Anirudh-65/FPGA-Based_Hardware_Accelerated_Matrix-Multiplication_on_RISC-V_Using_Systolic-Array_Integration/Project_Documentation_RISCV_matmul.pdf

## FPGA-Based Hardware Acceleration of Matrix Multiplication on RISC-V Using a Custom Systolic Array

Arjun Mallya, Anirudh Mittal, Shah Tirth

July 4, 2025

Abstract

Matrix multiplication is a core computational primitive in signal processing, scientific computing, and machine learning, yet its inherent O(n

3
) complexity makes it a major performance bottleneck on sequential processors. This report presents a hardware-accelerated implementation of matrix multiplication through a custom instruction extension to the RV32IM RISC-V core. A dedicated systolic array accelerator is integrated into the five-stage RISC-V pipeline via a custom matmul instruction, with modifications made to both the GNU RISC-V toolchain and the Spike simulator for software simulation. The Verilog-based hardware architecture incorporates a wrapper for operand control, a counter for profiling, and UART for runtime validation. The complete system was prototyped on a Xilinx Nexys4 DDR FPGA [?], and performance profiling via waveform analysis and post-implementation timing reports demonstrated a substantial reduction in execution cycles, reducing the effective computational complexity significantly. This work underscores the potential of custom ISA extensions and domain-specific accelerators in advancing the performance of open-source RISC-V-based embedded computing platforms.

## Contents

1 Introduction | 4
2 Theoretical Background | 4
3 Module Overview | 7
4 Introduction to RISC-V GNU Toolchain and Spike ISA Simulator | 22

### 5 Integration of Custom Matmul instruction to GNU Toolchain and Spike Simulator 23

6 Modifications to RISC-V GNU Toolchain | 24
7 Modifications to RISC-V Spike Simulator | 24

8 Current Status and Testing | 25

## 1 Introduction

RISC-V is an open-source, modular ISA known for its simplicity and extensibility. The RV32IM variant, featuring a 32-bit integer instruction set and a classic five-stage pipeline, is ideal for custom instruction integration and experimentation with hardware accelerators. To overcome the O(n

3
) cost of matrix multiplication on sequential processors, we extend the RISC-V ISA with a custom matmul instruction. This instruction is supported end-to-end—from software simulation using a modified Spike toolchain to hardware acceleration via a systolic array integrated on FPGA—significantly reducing execution time while preserving pipeline compatibility.

## 2 Theoretical Background

This section outlines the theoretical foundations essential for understanding the design and implementation of a custom matrix multiplication instruction within the RV32IM RISC-V architecture, including the integration of a hardware accelerator and associated peripheral systems.

### 2.1 RISC-V Instruction Set Architecture (ISA)

RISC-V is an open-source, modular ISA designed to support a wide range of computing systems. Its clean, extensible architecture has led to widespread academic and industrial adoption. The base ISA is categorized by its register width and supported instruction types. In this project, we use the RV32IM variant, which supports 32-bit integer operations (RV32I) and integer multiplication and division extensions (M).

### 2.2 General Purpose Registers (GPRs)

RISC-V defines 32 general-purpose registers (x0–x31), each 32 bits wide in the RV32 architecture. Register x0 is hardwired to zero. The standard naming convention for these registers is as follows:

Register | ABI Name | Description
x0 x1 x2 x3 x4 x5–x7 x8 x9 x10–x11 x12–x17 x18–x27 x28–x31 | zero ra sp gp tp t0–t2 s0/fp s1 a0–a1 a2–a7 s2–s11 t3–t6 | Constant zero Return address Stack pointer Global pointer Thread pointer Temporaries Saved register / frame pointer Saved register Function arguments / return values Function arguments Saved registers Temporaries

Table 1: RISC-V General Purpose Registers

### 2.3 Pipeline Architecture and Instruction Decoding

The RV32IM core used in our design is a classic 5-stage pipeline architecture comprising the following stages:

- Instruction Fetch (IF): Retrieves instructions from memory.
- Instruction Decode (ID): Decodes the fetched instruction and reads operands from the register file.

- Execute (EX): Performs ALU operations or address computation.
- Memory Access (MEM): Accesses data memory for load/store instructions.
- Write Back (WB): Writes results back to the register file.

In the decode stage, the instruction is identified based on the opcode, funct3, and funct7 fields. Custom instructions use opcodes from the reserved CUSTOM-0 to CUSTOM-3 space.

### 2.4 RISC-V Instruction Formats

RISC-V defines several instruction formats to accommodate different types of operations within its reduced instruction set architecture. Each format specifies how the 32-bit instruction word is partitioned into opcode, register identifiers, immediate values, and function fields. The primary formats used in the RV32I base ISA are:

- R-type: Used for register-register operations (e.g., add, sub, mul)
- I-type: Used for immediate operations and loads (e.g., addi, lw)
- S-type: Used for store instructions (e.g., sw)
- B-type: Used for conditional branches (e.g., beq, bne)
- U-type: Used for upper immediate operations (e.g., lui, auipc)
- J-type: Used for jump instructions (e.g., jal)
Format | Fields (bit positions) | Use Case
R-type I-type S-type B-type U-type J-type | [31:25] funct7, [24:20] rs2, [19:15] rs1, [14:12] funct3, [11:7] rd, [6:0] opcode [31:20] imm, [19:15] rs1, [14:12] funct3, [11:7] rd, [6:0] opcode [31:25] imm[11:5], [24:20] rs2, [19:15] rs1, [14:12] funct3, [11:7] imm[4:0], [6:0] opcode [31], [30:25], [11:8], [7] (combined as imm), [24:20] rs2, [19:15] rs1, [14:12] funct3, [6:0] opcode [31:12] imm, [11:7] rd, [6:0] opcode [31], [30:21], [20], [19:12] (combined as imm), [11:7] rd, [6:0] opcode | Register-register ALU ops Loads, immediate ALU ops Stores Conditional branches Load upper immediate, AUIPC Jumps

Table 2: RISC-V Instruction Formats

### 2.5 Our Custom matmul Instruction Format

The custom matmul instruction follows the R-type format, aligning with standard ALU operations. It uses the CUSTOM-0 opcode space, which is reserved for user-defined extensions. This design ensures compatibility with the RISC-V decoder logic and avoids conflicts with standard instructions.

1 | ‘define OPCODE_CUSTOM_0 | 7 ’ b0001011
2 | ‘define FUNCT3_MATMUL | 3 ’ b000
3 | ‘define FUNCT7_MATMUL | 7 ’ b0000000

4
5 | ‘define INST_MATMUL | { ‘FUNCT7_MATMUL , 5 ’ h0 , 5 ’ h0 , ‘FUNCT3_MATMUL , 5 ’ h0 ,
| ‘OPCODE_CUSTOM_0 }
6 | ‘define INST_MATMUL_MASK | {7 ’ h7F , 5 ’ h0 , 5 ’ h0 , 7 ’ h7 , 5 ’ h0 , 7 ’ h7F }

Listing 1: Custom Matrix Multiplication Instruction Definition

In this instruction:

- rd stores the base address of matrix C (the result),
- rs1 and rs2 store the base addresses of matrices A and B, respectively.

When this instruction is detected in the Decode (ID) stage of the processor, the pipeline is stalled and control is handed over to the custom Matmul Wrapper module. This wrapper loads the operands from memory, interfaces with the Systolic Array for computation, and writes the resulting matrix back to the memory starting at the address specified by rd.
This setup allows for tight coupling between the custom hardware accelerator and the RISC-V core, ensuring low-latency interaction and efficient data movement through the memory system. It exemplifies the flexibility of RISC-V in supporting domain-specific architectural extensions.

### 2.6 Systolic Array and Hardware Acceleration

The systolic array is a 2D mesh of processing elements that enables high-throughput matrix multiplication. It operates on streamed data with inherent parallelism and is particularly efficient for dense matrix operations.
In our implementation, a Matmul Wrapper module handles the interface between the RISC-V core and the systolic array. It fetches the operand matrices from memory, streams them into the array, and writes the result matrix back to memory.

### 2.7 Performance Counters

To evaluate performance, a 64-bit hardware performance counter was integrated. This counter starts on execution and stops upon completion of the matmul operation. It can be accessed through custom Control and Status Registers (CSRs). The counter tracks the total number of clock cycles taken by a program, enabling accurate performance profiling and comparison between hardware-accelerated and software-only executions.

### 2.8 UART (Universal Asynchronous Receiver Transmitter)

UART is a hardware communication protocol that facilitates serial data transfer between the FPGA and a host PC. It converts parallel data from the processor into serial form and vice versa. UART was used in this project for debugging and verification purposes by transmitting matrix values and performance results from the FPGA to a PC terminal.
The UART setup includes:
- Baud Rate Configuration
- Data Register Interface
- Start/Stop Bit Synchronization

The UART was instantiated and mapped to specific memory addresses in the address space, enabling the processor to write data directly to it for transmission.

### 2.9 FPGA and Vivado Integration

The hardware design was implemented on a Xilinx Nexys4 DDR FPGA, an educational development board powered by the Artix-7 FPGA. The board includes:

- 15,850 logic slices
- 4,860 Kbits of block RAM
- 90 DSP slices

- On-board USB-JTAG and UART

We used Vivado Design Suite for synthesis, placement, routing, and timing analysis. During post-implementation, we observed timing violations due to default 100 MHz clocking. These were mitigated using Vivado’s Clock Wizard IP to generate a 65 MHz derived clock that met all timing constraints, ensuring reliable execution.

Together, these components formed the theoretical and practical foundation for realizing the project goal of efficient hardware-accelerated matrix multiplication using custom RISC-V extensions.

## 3 Module Overview

### 3.1 Riscv Fetch

Purpose:

- Requests instructions from the instruction cache using the current Program Counter (PC).
- Handles stalls, cache responses, and flushes due to mispredicted branches or exceptions.
- Updates the PC, including branch redirection and privilege management.
- Buffers fetch responses using a skid buffer.
- Reports fetch errors such as access faults or page faults.

Inputs:

clk i | Clock input signal. Synchronizes fetch logic.
rst i | Active-high reset. Clears internal state.
fetch accept i | Downstream stage ready to accept fetched instruction.
icache accept i | Instruction cache ready to accept new fetch request.
icache valid i | Valid instruction from instruction cache.
icache error i | Error occurred during instruction fetch (e.g., access fault).
icache inst i[31:0] | Instruction data from cache.
icache page fault i | Page fault indication during fetch.
fetch invalidate i | Invalidate current fetch (e.g., pipeline flush).
branch request i | Indicates a branch redirect.
branch pc i[31:0] | Target PC for branch.
branch priv i[1:0] | Privilege level of branch target.

Outputs:

fetch valid o | Instruction valid for decode.
fetch instr o[31:0] | Instruction to be decoded.
fetch pc o[31:0] | Program Counter of fetched instruction.
fetch fault fetch o | Fetch error (e.g., access fault).
fetch fault page o | Fetch page fault.
icache rd o | Request to read instruction cache.
icache flush o | Flush invalid instruction from cache.
icache invalidate o | Invalidate instruction cache line.
icache pc o[31:0] | PC address for cache read.
icache priv o[1:0] | Privilege level for PC.
squash decode o | Signal to squash instruction in decode stage.

### 3.2 Riscv Decode

Purpose:

- Translates raw 32-bit instruction data into processor control commands.
- Generates control signals for ALU, memory access, and branch units in later pipeline stages.
- Manages pipeline flow by stalling or squashing instructions based on control signals.
- Critical for identifying instructions related to matrix multiplication such as load, multiply, add, and branch.

Inputs:

clk i | System clock (from riscv core).
rst i | System reset (from riscv core).
fetch in valid i | Indicates a new instruction is ready (from fetch).
fetch in instr i | The 32-bit instruction data (from fetch).
fetch in pc i | Instruction memory address (from fetch).
fetch in fault fetch i | Instruction fetch error flag (from fetch).
fetch in fault page i | Instruction fetch page fault flag (from fetch).
fetch out accept i | Signals the Issue stage is ready.
squash decode i | Command to cancel the current instruction (from fetch).

Outputs:

fetch in accept o | Signals this Decode stage is ready (to fetch).
fetch out valid o | Indicates decoded output is valid (to issue).
fetch out instr o | The decoded instruction (to issue).
fetch out pc o | The instruction’s PC (to issue).
fetch out fault fetch o | Fault flags, passed through (to issue).
fetch out fault page o | Page fault flag, passed through (to issue).
fetch out instr exec o | Control signal for ALU operations (to issue).
fetch out instr lsu o | Control signal for Load/Store operations (to issue).
fetch out instr branch o | Control signal for Branch/Jump operations (to issue).
fetch out instr mul o | Control signal for Multiply unit (to issue).
fetch out instr div o | Control signal for Divide unit (to issue).
fetch out instr csr o | Control signal for CSR access (to issue).
fetch out instr rd valid o | Signals a register write-back is needed (to issue).
fetch out instr invalid o | Flags an illegal instruction (to issue).

### 3.3 Riscv Decoder

Purpose:

- Implements the RISC-V ISA decoding as a purely combinational logic block.
- Matches the input opcode against predefined bitmasks for all supported instructions.
- Categorizes instructions by asserting control flags (e.g., exec o, lsu o).
- Acts as the core control unit, directing instructions to the appropriate execution hardware.

Inputs:

valid i | Indicates the input instruction is valid (from riscv decode).

fetch fault i | Indicates a fetch error occurred (from riscv decode).
enable muldiv i | Enables the M-extension (multiply/divide instructions) (from riscv decode).
opcode i | The 32-bit raw instruction word (from riscv decode).

Outputs:

invalid o | Asserted for unrecognized or illegal opcodes (to riscv decode logic).
exec o | Asserted for ALU instructions (to riscv decode logic).
lsu o | Asserted for Load/Store instructions (to riscv decode logic).
branch o | Asserted for Branch and Jump instructions (to riscv decode logic).
mul o | Asserted for Multiply instructions (to riscv decode logic).
div o | Asserted for Divide/Remainder instructions (to riscv decode logic).
csr o | Asserted for system and CSR instructions (to riscv decode logic).
rd valid o | Asserted if the instruction writes a result to a register (to riscv decode logic).

### 3.4 Riscv Exec

Purpose:

- Executes core operations based on decoded instruction information.
- Generates immediates of various types (I, B, J, U) with proper sign-extension.
- Performs ALU operations such as arithmetic, logic, and shifts.
- Calculates branch/jump target addresses.
- Determines branch prediction outcomes (taken/not taken).
- Forwards ALU results for register file writeback.
- Controls pipeline by signaling branch requests to Fetch/Decode stages.

Inputs:

clk i | Clock input for sequential logic.
rst i | Asynchronous active-high reset.
opcode valid i | Indicates if current instruction in execute stage is valid.
opcode opcode i[31:0] | Full 32-bit instruction opcode.
opcode pc i[31:0] | Program Counter value for current instruction.
opcode invalid i | Flag indicating if instruction is invalid (from Decode stage).
opcode rd idx i[4:0] | Destination register index (rd).
opcode ra idx i[4:0] | Source register A index (rs1).
opcode rb idx i[4:0] | Source register B index (rs2).
opcode ra operand i[31:0] | Value of first source operand (register file read).
opcode rb operand i[31:0] | Value of second source operand (register file read).
hold i | Pipeline stall signal (from memory hazards or data hazards).

Outputs:

branch request o | Signals Fetch/Decode stages about executing a branch in-struction requiring PC update.
branch is taken o | Indicates conditional branch is predicted taken.
branch is not taken o | Indicates conditional branch predicted not taken.
branch source o[31:0] | PC of the branch-causing instruction.
branch is call o | Indicates a function call branch (e.g., JAL, JALR with rd = x1).
branch is ret o | Indicates a function return branch (e.g., JALR to x1 with zero immediate).
branch is jmp o | Indicates an unconditional jump branch.
branch pc o[31:0] | Calculated target PC for the branch.
branch d request o | Delayed branch request signal (typically 1 cycle delay).
branch d pc o[31:0] | Delayed branch target PC.
branch d priv o[1:0] | Dummy privilege output (always 2’b00, no privilege han-dling here).
writeback value o[31:0] | ALU operation result to be written back to register file.

### 3.5 Arithmetic Logic Unit (ALU)

Purpose:

- Core component of the Execute (EX) stage in the RISC-V processor.
- Performs arithmetic and logical operations such as addition, subtraction, bitwise AND, OR, XOR, shifts, and comparisons.
- Uses control signals to select the operation to perform on two operand inputs.
- Produces a result used for calculations, branch decisions, and memory address computations.

Inputs:

alu op[3:0] | ALU operation selector (opcode), controls the operation per-formed. Defined in riscv defs.v.
alu a i[31:0] | Operand A, sourced from the register file.
alu b i[31:0] | Operand B, sourced from the register file.

Outputs:

alu p o[31:0] | ALU result after performing the selected operation on operands A and B.

Opcode Macros:

- ALU ADD
- ALU SUB
- ALU AND
- ALU OR
- ALU XOR

- ALU LESS THAN
- ALU LESS SIGNED
- ALU SHIFTL
- ALU SHIFTR
- ALU SHIFT ARITH

### 3.6 Riscv Issue

Purpose:

- Acts as the control center between Decode and Execute stages.
- Routes decoded signals to appropriate modules while managing pipeline hazards.
- Decodes instructions into opcode, rs1, rs2, rd and reads required registers from the register file.
- Identifies hazards and forwards results to execution units to prevent stalls.
- Stalls the pipeline if forwarding is not possible (e.g., slow operations like division).
- Receives writeback values from execution modules and writes them to the appropriate registers.

Inputs:

clk i | System clock.
rst i | System reset.
fetch valid i | Indicates if a valid instruction is ready.
fetch instr i | The 32-bit raw instruction word.
fetch pc i | PC of the fetched instruction.
fetch fault fetch i | Instruction fetch error from memory.
fetch fault page i | Instruction page fault from MMU.
fetch instr exec i | Decoded: standard ALU operation?
fetch instr lsu i | Decoded: Load/Store operation?
fetch instr branch i | Decoded: Branch/Jump operation?
fetch instr csr i | Decoded: CSR operation?
fetch instr rd valid i | Decoded: Writes to register?
fetch instr invalid i | Decoded: Invalid instruction?
branch exec request i | Branch request signal from Execute.
branch exec is taken i | Indicates conditional branch predicted taken (from Exe-cute).
branch exec is not taken i | Indicates conditional branch predicted not taken (from Ex-ecute).
branch exec source i | PC of the branch-causing instruction (from Execute).
branch exec is call i | Indicates a function call branch (from Execute).
branch exec is ret i | Indicates a function return branch (from Execute).
branch exec is jmp i | Indicates an unconditional jump branch (from Execute).
branch exec pc i | Target PC for the branch (from Execute).
branch d exec request i | Delayed branch request (from Execute).
branch d exec pc i | Delayed target PC (from Execute).
branch d exec priv i | Delayed privilege info (from Execute).
writeback exec value i | Result from standard ALU operations (from Execute).
exec stall request i | Stall request from Execute (e.g., Matmul busy).

exec rd idx i | Destination register index in Execute stage.
writeback mem valid i | Indicates if memory access result is valid.
writeback mem value i | Data read from memory for forwarding.
writeback mem exception i | Memory access exception.
lsu stall i | Stall request from LSU (e.g., cache miss).
csr result e1 value i | Value read from CSR.
csr result e1 write i | CSR write enable.
csr result e1 wdata i | Data to write to CSR.
csr result e1 exception i | CSR-related exceptions (e.g., ecall).
branch csr request i | Branch request from CSR.
branch csr pc i | Target PC from CSR branch.
branch csr priv i | Privilege level from CSR branch.
take interrupt i | Global interrupt pending.
d stall | External debug stall signal from DataHazard.

Outputs:

fetch accept o | Signals that riscv fetch is ready for the next instruction.
branch request o | Global branch signal to update the PC.
branch pc o | Target PC for the branch.
branch priv o | Privilege level for the branch target.
exec opcode valid o | Valid instruction signal for riscv exec.
opcode opcode o | Instruction word passed to riscv exec.
opcode pc o | Instruction PC passed to riscv exec.
opcode invalid o | Invalid instruction flag for riscv exec.
opcode rd idx o | Destination register index passed to riscv exec.
opcode ra idx o | Source register A index passed to riscv exec.
opcode rb idx o | Source register B index passed to riscv exec.
opcode ra operand o | Prepared operand A value for riscv exec.
opcode rb operand o | Prepared operand B value for riscv exec.
lsu opcode valid o | Valid signal for riscv lsu.
lsu opcode opcode o | Instruction word to riscv lsu.
lsu opcode pc o | Instruction PC to riscv lsu.
lsu opcode invalid o | Invalid instruction flag for riscv lsu.
lsu opcode rd idx o | Destination register index to riscv lsu.
lsu opcode ra idx o | Source register A index to riscv lsu.
lsu opcode rb idx o | Source register B index to riscv lsu.
lsu opcode ra operand o | Operand A to riscv lsu.
lsu opcode rb operand o | Operand B to riscv lsu.
csr opcode valid o | Valid signal to CSR unit.
csr opcode opcode o | Instruction word to CSR unit.
csr opcode pc o | Instruction PC to CSR unit.
csr opcode invalid o | Invalid instruction flag to CSR unit.
csr opcode rd idx o | Destination register index to CSR unit.
csr opcode ra idx o | Source register A index to CSR unit.
csr opcode rb idx o | Source register B index to CSR unit.
csr opcode ra operand o | Operand A to CSR unit.
csr opcode rb operand o | Operand B to CSR unit.
csr writeback write o | CSR write enable signal.
csr writeback waddr o | CSR write address.
csr writeback wdata o | CSR write data.

csr writeback exception o | CSR exception flag.
csr writeback exception pc | oPC causing CSR exception.
csr writeback exception addrException address for CSR. o
exec hold o | Stall signal for riscv exec pipeline register.
mul hold o | Stall signal for riscv multiplier pipeline register.
interrupt inhibit o | Signal to temporarily block interrupts.

### 3.7 DataHazard Unit

Purpose:

- Implements a forwarding (or bypassing) mechanism to resolve read-after-write (RAW) data hazards without stalling.
- Checks if the operands needed by the instruction in the Decode stage are being produced by instructions currently in the Execute or Memory stages.
- If a dependency exists, it bypasses the register file and directly forwards the newer result from the Execute or Memory stage to the ALU’s input.
- This forwarding avoids pipeline stalls on dependent instructions, which are common in tight loops and algorithms like matrix multiplication.

Inputs:

reset i | System reset.
id ra index w | Source register 1 index (rs1) in Decode stage.
id rb index w | Source register 2 index (rs2) in Decode stage.
ex rd index r | Destination register index (rd) in Execute stage.
mem rd index w | Destination register index (rd) in Memory stage.
id ra value r | Operand value 1 read from register file in Decode stage.
id rb value r | Operand value 2 read from register file in Decode stage.
ex alu res r | ALU result produced in Execute stage.
mem wb alu result r | ALU result from instruction in Memory stage.
mem rdata w | Data fetched from memory in Memory stage.
mem access w | Indicates memory load occurred in Memory stage.

Outputs:

exe ra r | Corrected operand A value forwarded to Execute stage ALU.
exe rb r | Corrected operand B value forwarded to Execute stage ALU.

### 3.8 Hazard

Purpose:

- Detects the load-use data hazard, where an instruction needs data that a preceding load instruction has not yet fetched from memory.
- Compares the current instruction’s source registers (rs1 or rs2) with the destination register (rd) of the immediately preceding instruction.
- Specifically targets cases where the preceding instruction is a load word (lw).
- If such a hazard is found, asserts the stall signal to pause the pipeline for one cycle, allowing memory access to complete.

- Ensures correctness in common dependency patterns, such as multiply-add sequences in matrix multiplication.

Inputs:

opcode i | The instruction just fetched from memory (from mem i inst i port).
clk i | System clock.
reset i | System reset.

Outputs:

stall | Single-bit signal to pause the pipeline if a load-use hazard is detected.

### 3.9 riscv core

Purpose:

- Acts as the top-level ”schematic” of the processor, instantiating and connecting all major functional blocks (fetch, decode, exec, lsu, multiplier, etc.).
- Defines the complete pipeline structure and orchestrates instruction and data flow across all pipeline stages.
- Connects all control and data paths, including forwarding logic and the stall signal from the DataHazard unit to the issue stage.
- Serves as the boundary between the CPU core and the external system.
- Manages external communication with instruction/data memory and interrupt controllers.

Inputs:

clk i | System clock (from Testbench/System).
rst i | System reset (from Testbench/System).
mem d data rd i | Data received from a load operation (from External Data Memory).
mem d accept i | Data memory handshake signal: memory accepts new re-quest.
mem d ack i | Data memory handshake signal: read/write complete.
mem d error i | Data memory error signal.
mem i inst i | Instruction data fetched from memory (from External In-struction Memory).
mem i accept i | Instruction memory handshake signal: memory accepts new request.
mem i valid i | Instruction memory handshake signal: instruction valid.
mem i error i | Instruction memory error signal.
intr i | External interrupt request (from Testbench/System).
reset vector i | Address where execution starts after reset.
cpu id i | Identifier for the processor core.

Outputs:

mem d addr o | Address for a memory operation (to External Data Mem- ory).

data wr o | Data to be written to memory.
mem d rd o | Read enable for data memory.
wr o | Write enable for data memory.
mem i pc o | Program Counter sent to fetch an instruction (to External Instruction Memory).
mem i rd o | Read enable for instruction memory.
mem d cacheable o | Indicates if data memory access is cacheable.
mem i cacheable o | Indicates if instruction memory access is cacheable.
invalidate o | Cache invalidate signal (to memory system).
flush o | Cache flush signal (to memory system).

### 3.10 instruction memory

Purpose:

- Represents the Instruction ROM (Read-Only Memory) in the Fetch stage of a RISC-V processor pipeline.
- Holds the program code and outputs a 32-bit instruction based on the Program Counter (PC).
- Accepts a word-aligned address and provides the corresponding instruction, either combinationally or synchronously.
- Always ready to serve fetch requests, supporting uninterrupted instruction flow unless externally stalled.

Inputs:

clk i | Clock signal. Present for compatibility; unused in current combinational implementation.
reset i | Reset signal. Included for extensibility; not used in current implementation.
iaddr i[31:0] | Address input from the Program Counter (PC) to access the instruction memory.
ird i | Instruction read enable. Present for future extensibility; un-used in current implementation.

Outputs:

accept | Always set to 1, indicating readiness to serve instruction fetches.
irdata o[31:0] | Instruction fetched from memory based on iaddr i; sent to Decode stage.

### 3.11 data memory

Purpose:

- Represents the data memory (RAM) used during the Memory Access (MEM) stage of the RISC-V processor pipeline.
- Supports both read and write operations with byte-level granularity.
- Handles accesses of various sizes—byte, half-word, and word—using byte-enable control signals.
- Interfaces with the processor pipeline to execute load/store instructions and manage data movement accordingly.

Inputs:

clk i | Clock signal required for synchronous memory operations.
reset i | Resets internal memory state and output signals.
daddr i[31:0] | Word-aligned address for memory access, typically ALU out-put.
dwdata i[31:0] | Data input used during store operations.
dsize i[1:0] | Data size selector: 00 = byte (8-bit), 01 = half-word (16-bit), 10 = word (32-bit).
drd i | Read enable signal, asserted for load instructions.
dwr i | Write enable signal, asserted for store instructions.
dbe w[3:0] | Byte-enable mask; each bit enables writing a corresponding byte in the 32-bit word.

Outputs:

drdata o[31:0] | Data read from memory when drd i is asserted.
accept | Handshake signal indicating readiness to perform a memory operation.
acknowledge | Signals completion of the current memory transaction.

### 3.12 riscv csr

Purpose:

- Acts as the interface between the instruction pipeline and the CSR register file.
- Decodes and executes CSR-related instructions (e.g., CSRRW, ECALL, MRET).
- Detects early exceptions such as illegal CSR accesses or system calls.
- Prepares CSR data for writes, sets, or clears.
- Manages pipeline control signals including traps, returns, flushes, and interrupts.
- Interfaces with the MMU by providing configuration signals and flushing TLB.
- Asserts interrupt requests when enabled and pending.

Inputs:

clk i | Clock input.
rst i | Asynchronous active-high reset.
intr i | External interrupt signal.
opcode valid i | Indicates if current instruction is valid.
opcode opcode i[31:0] | Instruction opcode.
opcode pc i[31:0] | Program Counter of the current instruction.
opcode invalid i | Invalid instruction flag.
opcode rd idx i[4:0] | Destination register index.
opcode ra idx i[4:0] | Source register A index or immediate.
opcode rb idx i[4:0] | Source register B index.
opcode ra operand i[31:0] | Operand value from source register A.
opcode rb operand i[31:0] | Operand value from source register B.
csr writeback write i | Writeback enable signal to CSR from later stage.
csr writeback waddr i[11:0] CSR address for writeback.
csr writeback wdata i[31:0] Data to write into CSR.

csr writeback exception i[5:0] Exception code from later pipeline stage.
csr writeback exception pc | i[31:0] PC of faulting instruction.
csr writeback exception addrAddress associated with exception. i[31:0]
cpu id i[31:0] | CPU identifier (mhartid).
reset vector i[31:0] | Reset vector for initial PC.
interrupt inhibit i | Signal to temporarily suppress interrupts.

Outputs:

csr result e1 value o[31:0] | Value read from CSR or fault-related value.
csr result e1 write o | Write enable for CSR result to register file.
csr result e1 wdata o[31:0] | Data to be written to CSR.
csr result e1 exception o[5:0]Exception code generated by CSR module.
branch csr request o | Indicates a trap or xRET branch should be taken.
branch csr pc o[31:0] | Target PC for trap or return.
branch csr priv o[1:0] | Privilege level after trap/return.
take interrupt o | Signal to trigger interrupt handling.
ifence o | Triggers instruction cache flush (FENCE.I).
mmu priv d o[1:0] | Effective privilege level for MMU.
mmu sum o | mstatus.SUM bit output.
mmu mxr o | mstatus.MXR bit output.
mmu flush o | Triggers TLB flush.
mmu satp o[31:0] | Current satp CSR value.

### 3.13 riscv performance counter

Purpose:

- Measures the number of clock cycles between program start and a halt instruction.
- Starts counting when the first instruction is fetched at PC 0x00000000.
- Stops counting when an instruction is fetched at PC 0x00000088.
- Outputs the total cycle count once halted.
- Indicates whether counting is active and whether measurement is complete.
- Flags detection of the halt instruction.

Inputs:

clk i | Clock signal driving the performance counter.
reset i | Asynchronous reset signal; clears internal state and coun-ters.
pc i[31:0] | Current Program Counter input used to detect start and halt points.
instruction i[31:0] | Instruction at the current PC; not directly used for logic, but passed in.
instruction valid i | Indicates whether the instruction at the current PC is valid. Required to recognize start and halt conditions.

Outputs:

cycle count o[31:0] | Total number of cycles counted between start and halt.

counting active o | High when cycle counting is in progress.
measurement done o | High when halt condition is detected and cycle measurement is complete.
halt detected o | Asserted when halt instruction is fetched at PC 0x00000088.

### 3.14 matmul controller

Purpose:

- Orchestrates matrix multiplication using a systolic array accelerator.
- Fetches matrix A and B elements from memory into internal buffers.
- Triggers the systolic array computation once data is loaded.
- Writes the resulting matrix C back to memory.
- Manages memory access and pipeline timing using an FSM with distinct states for each phase.

Inputs:

clk i | Clock signal for synchronous logic.
rst i | Asynchronous reset signal to initialize internal states and counters.
start i | Start signal to initiate matrix multiplication.
addr a base i[31:0] | Base memory address of matrix A.
addr b base i[31:0] | Base memory address of matrix B.
addr c base i[31:0] | Base memory address where the result matrix C is to be written.
mem data rd i[31:0] | Data read from memory during matrix A/B fetch phase.
mem gnt i | Memory grant signal to indicate readiness to serve a request.
mem ack i | Memory acknowledgment signal indicating successful data transfer.

Outputs:

busy o | High when the controller is busy performing matrix multi-plication.
mem addr o[31:0] | Address sent to memory for reading matrix A/B or writing matrix C.
mem rd o | Read enable signal for memory interface.
mem wr o[3:0] | Write enable mask for memory writes (4 bits for byte-level granularity).
mem data wr o[31:0] | Data to be written to memory during matrix C store phase.
mem req o | Request signal asserting memory access initiation.

### 3.15 systolic array

Purpose:

- Implements a systolic array architecture for matrix multiplication.
- Takes input matrices matrix A and matrix B and produces the result matrix resMatrix.
- Uses time-skewed data movement to compute dot products in parallel over multiple cycles.

Inputs:

clk | Clock signal to drive computation steps and internal opera-tions.
reset | Synchronous reset to clear state and output registers.
matrix A | Input matrix A of size ROW A × COL A.
matrix B | Input matrix B of size ROW B × COL B.
initiateCompute | Control signal to begin matrix multiplication operation.

Outputs:

computeDone | Asserted high when the computation of resMatrix is com-plete.
resMatrix | Output matrix containing the result of A × B, of size ROW A × COL B.

### 3.16 MemoryUartDumper

Purpose:

- Dumps contents of memory via UART in hexadecimal format.
- Converts 8-bit memory data to ASCII hex and transmits it serially.
- Sends a formatted header, spaces between bytes, and newlines after 16 bytes.

Inputs:

clk | System clock signal, typically 50 MHz.
reset | Active-high synchronous reset signal.
start dump | Signal to begin the memory dump over UART.
mem rdata | 8-bit data input from memory at address mem addr.

Outputs:

dump in progress | High while memory is being dumped. Returns low when complete.
mem addr | Address line to fetch memory contents sequentially.
tx | UART serial transmit line carrying memory content in ASCII.
bytes sent debug | Debug counter of number of bytes transmitted.

### 3.17 uart tx

Purpose:

- Implements a UART transmitter for serial communication.
- Transmits 8-bit data over a single line at a fixed baud rate.
- Follows standard UART format: 1 start bit, 8 data bits, 1 stop bit, no parity.

Inputs:

clk | System clock used to time bit transmissions. Designed for 50 MHz.
reset | Active-high reset signal. Resets state, counters, and output.

data | 8-bit parallel data to be serialized and transmitted.
tx start | Pulse signal indicating a new byte should be transmitted.

Outputs:

tx | UART transmit line. Outputs serialized data (start, 8-bit data, stop).
tx busy | High during transmission of a byte, low when ready for new data.

### 3.18 riscv top

Purpose:

- Top-level RISC-V SoC module integrating clock wizard, performance counter, UART dumper, instruction/data memory, and core processor.
- Drives a 16-bit LED display for visual feedback on execution and status.
- Manages startup delay and memory dump functionality post-reset.

Inputs

Name | Description
clk 100mhz i | 100 MHz input clock signal.
rst i | Asynchronous reset signal.
intr i | External interrupt signal input to the RISC-V core.

Outputs

Name | Description
tx o | UART transmit line used by the MemoryUartDumper to
send dumped memory contents.
led o [15:0] | LED output showing system status, cycle count, and halt
information.

### 3.19 Memory Dump UART Python Script

Purpose:

- Automatically identifies the correct COM port connected to the Nexys 4 DDR board.
- Reads the memory dump transmitted via UART.
- Displays both raw hexdump (little-endian) and interpreted 32-bit word values (big-endian).

Python Script:

1 | import serial
2 | import time
3 | import sys
4 | import re

5
6 | # find_nexys_port () function is unchanged and remains excellent .
7 | def find_nexys_port () :
8 | import serial . tools . list_ports
9 | ports = serial . tools . list_ports . comports ()
10 | nexys_ports = []

12 | print (" Searching for COM ports ...")
13 | for i , port in enumerate ( ports ) :
14 | if any ( keyword in port . description . lower () for keyword in
15 | [’digilent ’, ’ftdi ’, ’usb serial ’, ’nexys ’]) :
16 | nexys_ports . append ( port )

17
18 | if nexys_ports :
19 | print ( f"\ nFound {len( nexys_ports )} potential Nexys 4 DDR port (s):")
20 | for i , port in enumerate ( nexys_ports ) :
21 | print ( f" | { port . device } - { port . description }")

22
23 | try:
24 | higher_port = max( nexys_ports , key = lambda p : int( re . search (r’(\d
+)$’, p . device ) . group (1) ) )
25 | print ( f"\n- - > Automatically selecting higher numbered port : {
higher_port . device }\n")
26 | return higher_port . device
27 | except ( AttributeError , ValueError ) :
28 | print ("\n- - > Could not determine higher port , selecting first
found .\n")
29 | return nexys_ports [0]. device

30
31 | if not ports :
32 | print ("No COM ports found !")
33 | return None

34
35 | print ("\ nCould not automatically identify Nexys port .")
36 | for i , port in enumerate ( ports ) :
37 | print ( f" | {i}: { port . device } - { port . description }")
38 | try:
39 | choice = int ( input (" Enter the number of the port to use : ") )
40 | return ports [ choice ]. device
41 | except ( ValueError , IndexError ) :
42 | print (" Invalid selection . Exiting .")
43 | return None

44
45 | def process_and_print_buffer ( buffer ) :
46 | """
47 | Takes the raw text buffer , prints a clean hexdump , and then prints the
48 | interpreted 32 - bit integer values .
49 | """
50 | if not buffer :
51 | return

52
53 | print ("\n ========================= MEMORY DUMP RECEIVED
========================= ")

54
55 | # 1. Sanitize the input and get a clean list of bytes
56 | payload = buffer . split (" Memory Dump :\r\n", 1) [ -1]
57 | hex_string = re . sub (r’[^0 -9A-Fa -f]’, ’’, payload , flags = re . IGNORECASE )
58 | byte_list = [ hex_string [ i : i +2]. upper () for i in range (0 , len( hex_string )
, 2) ]

59
60 | # 2. Print the raw hexdump first (as seen in memory )
61 | print (" --- Raw Little - Endian Memory Content ---")
62 | for i in range (0 , len( byte_list ) , 16) :
63 | chunk = byte_list [ i : i +16]
64 | address = f"0x{i:04 X}: "
65 | hex_part = " ". join ( chunk )
66 | print ( f"{ address }{ hex_part }")

68 | # 3. Process and print the interpreted 32 - bit words
69 | print ("\n- - - Interpreted 32 - bit Words (Big - Endian ) ---")
70 | print (" Address | | Word 0 (Hex) | | Word 1 (Hex) | | Word 2 (Hex) | |
| Word 3 (Hex )")
71 | print (" | | Word 0 (Dec) | | Word 1 (Dec) | | Word 2 (Dec) | |
| Word 3 (Dec )")
72 | print ("
- - - - - - - - - - -+ - - - - - - - - - - - - - - - -+ - - - - - - - - - - - - - - - -+ - - - - - - - - - - - - - - - -+ - - - - - - - - - - - - - - - -
| ")

73
74 | for i in range (0 , len( byte_list ) , 16) :
75 | chunk = byte_list [ i : i +16]
76 | address = f" 0x{i:04 X} | |"
77 | hex_line_parts = []
78 | dec_line_parts = []

79
80 | for j in range (0 , len( chunk ) , 4) :
81 | word_bytes_little_endian = chunk [ j : j +4]
82 | if len( word_bytes_little_endian ) == 4:
83 | word_bytes_big_endian = word_bytes_little_endian [:: -1]
84 | hex_str = "". join ( word_bytes_big_endian )
85 | hex_line_parts . append ( f" 0x{ hex_str : <12}")
86 | decimal_val = int( hex_str , 16)
87 | dec_line_parts . append ( f" { decimal_val : <14}")

88
89 | print ( address + "". join ( hex_line_parts ) )
90 | print (" | |" + "". join ( dec_line_parts ) )

## 4 Introduction to RISC-V GNU Toolchain and Spike ISA Simulator

The RISC-V ecosystem provides open-source tools to write, compile, simulate, and test RISC-V assembly and C/C++ programs. Two key components in this flow are:

- GNU RISC-V Toolchain: Includes the compiler riscv32-unknown-elf-gcc, assembler, linker, and utilities like objcopy. It allows compilation of standard C/C++ programs targeting the RISC-V architecture.
- Spike ISA Simulator: Spike is the official RISC-V ISA simulator. It supports functional simulation and is ideal for debugging compiled RISC-V binaries.

### 4.1 Getting Started with Docker Container

To simplify the setup process, a pre-built Docker container is available with the GNU Toolchain and Spike already installed.

1 | docker pull arjunmallya / ubuntu : withmatmul
2 | docker run - it -- rm arjunmallya / ubuntu : withmatmul bash

Listing 2: Pull and run the Docker container

This opens a shell with the RISC-V toolchain and Spike pre-installed.

### 4.2 Compiling and Converting RISC-V C Code

### 4.2.1 Step 1: Navigate to Working Directory

1 cd / opt / cpp_nn_riscv

### 4.2.2 Step 2: Create and Compile a C File

Create a file named test.c with any RISC-V-compatible C code. For example:

1 | int main () {
2 | return 42;
3 | }

Listing 3: Simple C Program

Compile it using:

1 | riscv32 - unknown - elf - gcc - march = rv32i - mabi = ilp32 - nostdlib - Ttext =0 x0 -o test . elf
| test . c
- -march=rv32i: Targets base integer RISC-V ISA
- -mabi=ilp32: Uses 32-bit integer ABI
- -nostdlib: Omits linking the standard library
- -Ttext=0x0: Places code starting at address 0x0

### 4.2.3 Step 3: Generate Binary and Hex Files

Convert the ELF output to binary and then to hexadecimal:

1 | riscv32 - unknown - elf - objcopy -O binary test . elf test . bin
2 | hexdump -v -e ’1/4 "%08 x\n"’ test . bin > test . hex

### 4.2.4 Step 4: Clean and Format Hex for Verilog Use

To prepare the hex for use in Verilog simulations:

1 cat test . hex | tr -d ’\n\r’ | fold - w8 > test_clean . hex

Each line of test clean.hex will now be 8 characters (32 bits), suitable for Verilog memory initialization.

### 4.3 Summary of Commands

Task | Command/Tool
Compile C file Convert to binary Generate hex Format hex for Verilog Run Docker container | riscv32-unknown-elf-gcc riscv32-unknown-elf-objcopy hexdump tr, fold docker run

Table 39: Toolchain Workflow Summary

These tools provide a robust flow for writing, compiling, and testing custom C/C++ programs for RISC-V architectures.

## 5 Integration of Custom Matmul instruction to GNU Toolchain and Spike Simulator

The objective of this project is to extend the RISC-V instruction set with a custom matmul instruction. This instruction is intended to accelerate matrix multiplication operations, which are fundamental to applications such as neural networks. This document details the initial phase of integration into the Spike simulator, where the instruction operates on matrices of fixed, predefined dimensions.
The matmul instruction is designed as an R-type instruction with the following intended behavior
for this initial phase:
- Operation: Integer vector-matrix multiplication (output vector = input vector * weight matrix).
- Operands in GPRs:

– rs1: Holds the base memory address of the input vector (array of int8 t).

– rs2: Holds the base memory address of the weight matrix (array of int8 t).

– rd: Initially holds the base memory address for the output vector (array of int32 t). After execution, rd is updated with a status code (0 for success).

- Data Types: Input elements are int8 t, weight elements are int8 t, and output/accumulator elements are int32 t.

## 6 Modifications to RISC-V GNU Toolchain

To enable the assembler and disassembler to recognize the new matmul instruction, the following modifications were made:

### 6.1 opcodes/riscv-opc.c

1 {" matmul ", 0 , INSN_CLASS_I , "d,s,t", 0 x0200000b , 0 xfe00707f , match_opcode , 0 } ,

Listing 4: Changes to matmul in riscv-opc.c

## 7 Modifications to RISC-V Spike Simulator

### 7.1 riscv/encoding.h

1 | # define MATCH_MATMUL 0 x0200000b
2 | # define MASK_MATMUL | 0 xfe00707f

3
4 | # ifdef DECLARE_INSN
5 | DECLARE_INSN ( matmul , MATCH_MATMUL , MASK_MATMUL )
6 | # endif

Listing 5: Changes to riscv/encoding.h

### 7.2 riscv/insns/matmul.h

1 | reg_t addr_a = RS1 ;
2 | reg_t addr_b = RS2 ;
3 | reg_t addr_c = RD ;

4
5 | // Read dimensions from registers x14 , x15 , x16
6 | size_t M = STATE . XPR [14];
7 | size_t N = STATE . XPR [15];
8 | size_t K = STATE . XPR [16];

9
10 | for ( size_t i = 0; i < M ; ++ i ) {
11 | for ( size_t j = 0; j < N ; ++ j ) {
12 | int32_t sum = 0;
13 | for ( size_t k = 0; k < K ; ++ k ) {
14 | int32_t a = MMU . load < int32_t >( addr_a + ( i * K + k ) * sizeof ( int32_t ) ) ;

15 | int32_t b = MMU . load < int32_t >( addr_b + ( k * N + j ) * sizeof ( int32_t ) ) ;
16 | sum += a * b ;
17 | }
18 | MMU . store < int32_t >( addr_c + ( i * N + j ) * sizeof ( int32_t ) , sum ) ;
19 | }
20 | }

21
22 WRITE_RD ( addr_c ) ;

Listing 6: Updated dynamic dimension implementation

### 7.3 riscv/riscv.mk.in

1 matmul \

### 7.4 riscv-isa-sim/disasm/disasm.cc

1 DEFINE_RTYPE ( matmul ) ;

Listing 7: Addition to disassembler

### 7.5 Rebuild Instructions

1 | ../ configure -- prefix =/ opt / riscv
2 | make clean
3 | make - j$( nproc )
4 | make install

## 8 Current Status and Testing

With the above modifications, the matmul instruction has been successfully integrated with dynamic dimension support.
A C++ test program was developed:
- Initializes matrices A, B, and C in memory using int32 t.
- Loads base addresses of A (into a0), B (into a1), and C (into a2).
- Loads M, N, K into a4, a5, a6 respectively.
- Executes: matmul a2, a0, a1.
- Verifies that C = A * B and checks the returned address.

The test confirms correct decoding, register usage, and memory-based matrix multiplication.
