Anirudh-65/FPGA-Based_Hardware_Accelerated_Matrix-Multiplication_on_RISC-V_Using_Systolic-Array_Integration/riscv_matmul/design_modules/riscv_core.v

//-----------------------------------------------------------------
//                         RISC-V Core
//                            V1.0.1
//                     Ultra-Embedded.com
//                     Copyright 2014-2019
//
//                   admin@ultra-embedded.com
//
//                       License: BSD
//-----------------------------------------------------------------
//
// Copyright (c) 2014-2019, Ultra-Embedded.com
// All rights reserved.
// 
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
module riscv_core
//-----------------------------------------------------------------
// Params
//-----------------------------------------------------------------
#(
     parameter SUPPORT_MULDIV   = 1
    ,parameter SUPPORT_SUPER    = 0
    ,parameter SUPPORT_MMU      = 0
    ,parameter SUPPORT_LOAD_BYPASS = 1
    ,parameter SUPPORT_MUL_BYPASS = 1
    ,parameter SUPPORT_REGFILE_XILINX = 0
    ,parameter EXTRA_DECODE_STAGE = 0
    ,parameter MEM_CACHE_ADDR_MIN = 32'h80000000
    ,parameter MEM_CACHE_ADDR_MAX = 32'h8fffffff
)
//-----------------------------------------------------------------
// Ports
//-----------------------------------------------------------------
(
    // Inputs
     input           clk_i
    ,input           rst_i
    ,input  [ 31:0]  mem_d_data_rd_i
    ,input           mem_d_accept_i
    ,input           mem_d_ack_i
    ,input           mem_d_error_i 
    ,input  [ 10:0]  mem_d_resp_tag_i
    ,input           mem_i_accept_i
    ,input           mem_i_valid_i
    ,input           mem_i_error_i
    ,input  [ 31:0]  mem_i_inst_i
    ,input           intr_i
//    ,input  [ 31:0]  reset_vector_i
//    ,input  [ 31:0]  cpu_id_i

    // Outputs
    ,output [ 31:0]  mem_d_addr_o
    ,output [ 31:0]  mem_d_data_wr_o
    ,output          mem_d_rd_o
    ,output [  3:0]  mem_d_wr_o
    ,output          mem_d_cacheable_o
    ,output [ 10:0]  mem_d_req_tag_o
    ,output          mem_d_invalidate_o
    ,output          mem_d_writeback_o
    ,output          mem_d_flush_o
    ,output          mem_i_rd_o
    ,output          mem_i_flush_o
    ,output          mem_i_invalidate_o
    ,output [ 31:0]  mem_i_pc_o
);
//

// Wires for matmul controller:

wire        fetch_instr_matmul_w;
wire        matmul_start_w;
wire [31:0] matmul_addr_a_w;
wire [31:0] matmul_addr_b_w;
wire [31:0] matmul_addr_c_w;
wire        matmul_busy_w;

wire [31:0] matmul_mem_addr_w;
wire        matmul_mem_rd_w;
wire [3:0]  matmul_mem_wr_w;
wire [31:0] matmul_mem_data_wr_w;
wire        matmul_mem_req_w;
wire        matmul_mem_gnt_w;

wire [31:0] lsu_mem_addr_w;
wire [31:0] lsu_mem_data_wr_w;
wire        lsu_mem_rd_w;
wire [3:0]  lsu_mem_wr_w;
wire        lsu_mem_cacheable_w;
wire [10:0] lsu_mem_req_tag_w;
wire        lsu_mem_invalidate_w;
wire        lsu_mem_writeback_w;
wire        lsu_mem_flush_w;
wire        lsu_mem_req_w;
wire        lsu_mem_gnt_w;

wire [31:0] arbitrated_mem_addr_w;
wire [31:0] arbitrated_mem_data_wr_w;
wire        arbitrated_mem_rd_w;
wire [3:0]  arbitrated_mem_wr_w;
wire        arbitrated_mem_cacheable_w;
wire [10:0] arbitrated_mem_req_tag_w;
wire        arbitrated_mem_invalidate_w;
wire        arbitrated_mem_writeback_w;
wire        arbitrated_mem_flush_w;



// Other wires:

wire           mmu_lsu_writeback_w;
wire  [  1:0]  fetch_in_priv_w;
wire  [  4:0]  mul_opcode_rd_idx_w;
wire           mmu_flush_w;
wire  [ 31:0]  lsu_opcode_pc_w;
wire           fetch_accept_w;
wire  [  4:0]  csr_opcode_rd_idx_w;
wire  [ 31:0]  branch_exec_source_w;
wire  [ 31:0]  csr_opcode_rb_operand_w;
wire  [ 31:0]  writeback_div_value_w;
wire           csr_opcode_valid_w;
wire           branch_csr_request_w;
wire  [ 31:0]  mmu_ifetch_inst_w;
wire  [ 31:0]  opcode_pc_w;
wire  [  4:0]  opcode_rb_idx_w;
wire           mmu_lsu_error_w;
wire           mul_opcode_valid_w;
wire           mmu_mxr_w;
wire  [  1:0]  branch_d_exec_priv_w;
wire           mmu_ifetch_valid_w;
wire           csr_opcode_invalid_w;
wire  [  5:0]  csr_writeback_exception_w;
wire           fetch_instr_mul_w;
wire           branch_exec_is_ret_w;
wire  [ 31:0]  csr_writeback_exception_addr_w;
wire  [  3:0]  mmu_lsu_wr_w;
wire           fetch_in_fault_w;
wire           branch_request_w;
wire  [ 31:0]  csr_opcode_pc_w;
wire           writeback_mem_valid_w;
wire  [  5:0]  csr_result_e1_exception_w;
wire  [ 31:0]  branch_csr_pc_w;
wire  [ 31:0]  mmu_lsu_data_wr_w;
wire           fetch_fault_page_w;
wire  [ 10:0]  mmu_lsu_resp_tag_w;
wire  [ 10:0]  mmu_lsu_req_tag_w;
wire  [ 31:0]  opcode_ra_operand_w;
wire           squash_decode_w;
wire           fetch_dec_fault_page_w;
wire  [ 31:0]  mul_opcode_opcode_w;
wire           exec_hold_w;
wire           fetch_instr_invalid_w;
wire  [ 31:0]  branch_pc_w;
wire  [  4:0]  mul_opcode_ra_idx_w;
wire  [  4:0]  csr_opcode_rb_idx_w;
wire           lsu_stall_w;
wire           branch_exec_is_not_taken_w;
wire  [ 31:0]  branch_exec_pc_w;
wire  [ 31:0]  opcode_opcode_w;
wire  [ 31:0]  mul_opcode_pc_w;
wire           branch_d_exec_request_w;
wire  [ 31:0]  mul_opcode_ra_operand_w;
wire           branch_exec_is_taken_w;
wire           fetch_dec_fault_fetch_w;
wire           fetch_dec_valid_w;
wire           fetch_fault_fetch_w;
wire           lsu_opcode_invalid_w;
wire  [ 31:0]  mmu_lsu_addr_w;
wire           mul_hold_w;
wire           mmu_ifetch_accept_w;
wire           mmu_lsu_ack_w;
wire  [ 31:0]  fetch_pc_w;
wire           mmu_ifetch_invalidate_w;
wire  [ 31:0]  mul_opcode_rb_operand_w;
wire  [  1:0]  branch_csr_priv_w;
wire           branch_exec_request_w;
wire  [ 31:0]  lsu_opcode_ra_operand_w;
wire           div_opcode_valid_w;
wire  [  1:0]  branch_priv_w;
wire           mmu_lsu_rd_w;
wire  [ 31:0]  fetch_dec_pc_w;
wire           interrupt_inhibit_w;
wire           mmu_ifetch_error_w;
wire  [  5:0]  writeback_mem_exception_w;
wire           fetch_instr_lsu_w;
wire  [  1:0]  mmu_priv_d_w;
wire  [  4:0]  opcode_ra_idx_w;
wire  [ 31:0]  csr_opcode_ra_operand_w;
wire  [ 31:0]  writeback_mem_value_w;
wire           writeback_div_valid_w;
wire  [  4:0]  mul_opcode_rb_idx_w;
wire           opcode_invalid_w;
wire           fetch_instr_branch_w;
wire  [ 31:0]  mmu_ifetch_pc_w;
wire           mmu_ifetch_rd_w;
wire           mmu_ifetch_flush_w;
wire  [  4:0]  lsu_opcode_rd_idx_w;
wire  [ 31:0]  lsu_opcode_opcode_w;
wire           mmu_load_fault_w;
wire  [ 31:0]  mmu_satp_w;
wire  [ 31:0]  csr_result_e1_wdata_w;
wire  [ 31:0]  opcode_rb_operand_w;
wire           mmu_lsu_invalidate_w;
wire           fetch_dec_accept_w;
wire  [  4:0]  csr_opcode_ra_idx_w;
wire           ifence_w;
wire           fetch_instr_exec_w;
wire  [  4:0]  opcode_rd_idx_w;
wire  [ 31:0]  csr_writeback_wdata_w;
wire           csr_writeback_write_w;
wire           take_interrupt_w;
wire  [ 31:0]  csr_result_e1_value_w;
wire  [ 31:0]  branch_d_exec_pc_w;
wire           fetch_valid_w;
wire  [ 11:0]  csr_writeback_waddr_w;
wire           branch_exec_is_jmp_w;
wire           mmu_lsu_cacheable_w;
wire           fetch_instr_csr_w;
wire           lsu_opcode_valid_w;
wire  [ 31:0]  fetch_dec_instr_w;
wire           csr_result_e1_write_w;
wire  [ 31:0]  csr_opcode_opcode_w;
wire           fetch_instr_div_w;
wire  [ 31:0]  fetch_instr_w;
wire           mul_opcode_invalid_w;
wire           fetch_instr_rd_valid_w;
wire  [ 31:0]  mmu_lsu_data_rd_w;
wire           exec_opcode_valid_w;
wire  [ 31:0]  writeback_mul_value_w;
wire           mmu_lsu_flush_w;
wire  [  4:0]  lsu_opcode_rb_idx_w;
wire           mmu_lsu_accept_w;
wire  [ 31:0]  lsu_opcode_rb_operand_w;
wire           mmu_sum_w;
wire  [ 31:0]  writeback_exec_value_w;
wire  [  4:0]  lsu_opcode_ra_idx_w;
wire  [ 31:0]  csr_writeback_exception_pc_w;
wire           mmu_store_fault_w;
wire           branch_exec_is_call_w;


riscv_exec
u_exec
(
    // Inputs
     .clk_i(clk_i)
    ,.rst_i(rst_i)
    ,.opcode_valid_i(exec_opcode_valid_w)
    ,.opcode_opcode_i(opcode_opcode_w)
    ,.opcode_pc_i(opcode_pc_w)
    ,.opcode_invalid_i(opcode_invalid_w)
    ,.opcode_rd_idx_i(opcode_rd_idx_w)
    ,.opcode_ra_idx_i(opcode_ra_idx_w)
    ,.opcode_rb_idx_i(opcode_rb_idx_w)
    ,.opcode_ra_operand_i(opcode_ra_operand_w)
    ,.opcode_rb_operand_i(opcode_rb_operand_w)
    ,.hold_i(exec_hold_w)

    // Outputs
    ,.branch_request_o(branch_exec_request_w)
    ,.branch_is_taken_o(branch_exec_is_taken_w)
    ,.branch_is_not_taken_o(branch_exec_is_not_taken_w)
    ,.branch_source_o(branch_exec_source_w)
    ,.branch_is_call_o(branch_exec_is_call_w)
    ,.branch_is_ret_o(branch_exec_is_ret_w)
    ,.branch_is_jmp_o(branch_exec_is_jmp_w)
    ,.branch_pc_o(branch_exec_pc_w)
    ,.branch_d_request_o(branch_d_exec_request_w)
    ,.branch_d_pc_o(branch_d_exec_pc_w)
    ,.branch_d_priv_o(branch_d_exec_priv_w)
    ,.writeback_value_o(writeback_exec_value_w)
);


riscv_decode
#(
     .EXTRA_DECODE_STAGE(EXTRA_DECODE_STAGE)
    ,.SUPPORT_MULDIV(SUPPORT_MULDIV)
)
u_decode
(
    // Inputs
     .clk_i(clk_i)
    ,.rst_i(rst_i)
    ,.fetch_in_valid_i(fetch_dec_valid_w)
    ,.fetch_in_instr_i(fetch_dec_instr_w)
    ,.fetch_in_pc_i(fetch_dec_pc_w)
    ,.fetch_in_fault_fetch_i(fetch_dec_fault_fetch_w)
    ,.fetch_in_fault_page_i(fetch_dec_fault_page_w)
    ,.fetch_out_accept_i(fetch_accept_w)
    ,.squash_decode_i(squash_decode_w)

    // Outputs
    ,.fetch_in_accept_o(fetch_dec_accept_w)
    ,.fetch_out_valid_o(fetch_valid_w)
    ,.fetch_out_instr_o(fetch_instr_w)
    ,.fetch_out_pc_o(fetch_pc_w)
    ,.fetch_out_fault_fetch_o(fetch_fault_fetch_w)
    ,.fetch_out_fault_page_o(fetch_fault_page_w)
    ,.fetch_out_instr_exec_o(fetch_instr_exec_w)
    ,.fetch_out_instr_lsu_o(fetch_instr_lsu_w)
    ,.fetch_out_instr_branch_o(fetch_instr_branch_w)
    ,.fetch_out_instr_mul_o(fetch_instr_mul_w)
    ,.fetch_out_instr_div_o(fetch_instr_div_w)
    ,.fetch_out_instr_csr_o(fetch_instr_csr_w)
    ,.fetch_out_instr_rd_valid_o(fetch_instr_rd_valid_w)
    ,.fetch_out_instr_invalid_o(fetch_instr_invalid_w)
    ,.fetch_out_instr_matmul_o(fetch_instr_matmul_w)
);


riscv_mmu
#(
     .MEM_CACHE_ADDR_MAX(MEM_CACHE_ADDR_MAX)
    ,.SUPPORT_MMU(SUPPORT_MMU)
    ,.MEM_CACHE_ADDR_MIN(MEM_CACHE_ADDR_MIN)
)
u_mmu
(
    // Inputs
     .clk_i(clk_i)
    ,.rst_i(rst_i)
    ,.priv_d_i(mmu_priv_d_w)
    ,.sum_i(mmu_sum_w)
    ,.mxr_i(mmu_mxr_w)
    ,.flush_i(mmu_flush_w)
    ,.satp_i(mmu_satp_w)
    ,.fetch_in_rd_i(mmu_ifetch_rd_w)
    ,.fetch_in_flush_i(mmu_ifetch_flush_w)
    ,.fetch_in_invalidate_i(mmu_ifetch_invalidate_w)
    ,.fetch_in_pc_i(mmu_ifetch_pc_w)
    ,.fetch_in_priv_i(fetch_in_priv_w)
    ,.fetch_out_accept_i(mem_i_accept_i)
    ,.fetch_out_valid_i(mem_i_valid_i)
    ,.fetch_out_error_i(mem_i_error_i)
    ,.fetch_out_inst_i(mem_i_inst_i),
   .lsu_in_addr_i(arbitrated_mem_addr_w),       
     .lsu_in_data_wr_i(arbitrated_mem_data_wr_w), 
     .lsu_in_rd_i(arbitrated_mem_rd_w),           
     .lsu_in_wr_i(arbitrated_mem_wr_w),           
     .lsu_in_cacheable_i(arbitrated_mem_cacheable_w),
     .lsu_in_req_tag_i(arbitrated_mem_req_tag_w),   
     .lsu_in_invalidate_i(arbitrated_mem_invalidate_w),
     .lsu_in_writeback_i(arbitrated_mem_writeback_w),
     .lsu_in_flush_i(arbitrated_mem_flush_w)    

    ,.lsu_out_data_rd_i(mem_d_data_rd_i)
    ,.lsu_out_accept_i(mem_d_accept_i)
    ,.lsu_out_ack_i(mem_d_ack_i)
    ,.lsu_out_error_i(mem_d_error_i)
    ,.lsu_out_resp_tag_i(mem_d_resp_tag_i)

    // Outputs
    ,.fetch_in_accept_o(mmu_ifetch_accept_w)
    ,.fetch_in_valid_o(mmu_ifetch_valid_w)
    ,.fetch_in_error_o(mmu_ifetch_error_w)
    ,.fetch_in_inst_o(mmu_ifetch_inst_w)
    ,.fetch_out_rd_o(mem_i_rd_o)
    ,.fetch_out_flush_o(mem_i_flush_o)
    ,.fetch_out_invalidate_o(mem_i_invalidate_o)
    ,.fetch_out_pc_o(mem_i_pc_o)
    ,.fetch_in_fault_o(fetch_in_fault_w)
    ,.lsu_in_data_rd_o(mmu_lsu_data_rd_w)
    ,.lsu_in_accept_o(mmu_lsu_accept_w)
    ,.lsu_in_ack_o(mmu_lsu_ack_w)
    ,.lsu_in_error_o(mmu_lsu_error_w)
    ,.lsu_in_resp_tag_o(mmu_lsu_resp_tag_w)
    ,.lsu_out_addr_o(mem_d_addr_o)
    ,.lsu_out_data_wr_o(mem_d_data_wr_o)
    ,.lsu_out_rd_o(mem_d_rd_o)
    ,.lsu_out_wr_o(mem_d_wr_o)
    ,.lsu_out_cacheable_o(mem_d_cacheable_o)
    ,.lsu_out_req_tag_o(mem_d_req_tag_o)
    ,.lsu_out_invalidate_o(mem_d_invalidate_o)
    ,.lsu_out_writeback_o(mem_d_writeback_o)
    ,.lsu_out_flush_o(mem_d_flush_o)
    ,.lsu_in_load_fault_o(mmu_load_fault_w)
    ,.lsu_in_store_fault_o(mmu_store_fault_w)
);


riscv_lsu
#(
     .MEM_CACHE_ADDR_MAX(MEM_CACHE_ADDR_MAX)
    ,.MEM_CACHE_ADDR_MIN(MEM_CACHE_ADDR_MIN)
)
u_lsu
(
    // Inputs
     .clk_i(clk_i)
    ,.rst_i(rst_i)
    ,.opcode_valid_i(lsu_opcode_valid_w)
    ,.opcode_opcode_i(lsu_opcode_opcode_w)
    ,.opcode_pc_i(lsu_opcode_pc_w)
    ,.opcode_invalid_i(lsu_opcode_invalid_w)
    ,.opcode_rd_idx_i(lsu_opcode_rd_idx_w)
    ,.opcode_ra_idx_i(lsu_opcode_ra_idx_w)
    ,.opcode_rb_idx_i(lsu_opcode_rb_idx_w)
    ,.opcode_ra_operand_i(lsu_opcode_ra_operand_w)
    ,.opcode_rb_operand_i(lsu_opcode_rb_operand_w)
    ,.mem_data_rd_i(mmu_lsu_data_rd_w)
    ,.mem_accept_i(lsu_mem_gnt_w)
    ,.mem_ack_i(mmu_lsu_ack_w)
    ,.mem_error_i(mmu_lsu_error_w)
    ,.mem_resp_tag_i(mmu_lsu_resp_tag_w)
    ,.mem_load_fault_i(mmu_load_fault_w)
    ,.mem_store_fault_i(mmu_store_fault_w),

    // Outputs
   .mem_addr_o(lsu_mem_addr_w),          
     .mem_data_wr_o(lsu_mem_data_wr_w),    
     .mem_rd_o(lsu_mem_rd_w),              
     .mem_wr_o(lsu_mem_wr_w),              
     .mem_cacheable_o(lsu_mem_cacheable_w),
     .mem_req_tag_o(lsu_mem_req_tag_w),    
     .mem_invalidate_o(lsu_mem_invalidate_w),
     .mem_writeback_o(lsu_mem_writeback_w),  
     .mem_flush_o(lsu_mem_flush_w)       

    ,.writeback_valid_o(writeback_mem_valid_w)
    ,.writeback_value_o(writeback_mem_value_w)
    ,.writeback_exception_o(writeback_mem_exception_w)
    ,.stall_o(lsu_stall_w)
);


riscv_csr
#(
     .SUPPORT_SUPER(SUPPORT_SUPER)
    ,.SUPPORT_MULDIV(SUPPORT_MULDIV)
)
u_csr
(
    // Inputs
     .clk_i(clk_i)
    ,.rst_i(rst_i)
    ,.intr_i(intr_i)
    ,.opcode_valid_i(csr_opcode_valid_w)
    ,.opcode_opcode_i(csr_opcode_opcode_w)
    ,.opcode_pc_i(csr_opcode_pc_w)
    ,.opcode_invalid_i(csr_opcode_invalid_w)
    ,.opcode_rd_idx_i(csr_opcode_rd_idx_w)
    ,.opcode_ra_idx_i(csr_opcode_ra_idx_w)
    ,.opcode_rb_idx_i(csr_opcode_rb_idx_w)
    ,.opcode_ra_operand_i(csr_opcode_ra_operand_w)
    ,.opcode_rb_operand_i(csr_opcode_rb_operand_w)
    ,.csr_writeback_write_i(csr_writeback_write_w)
    ,.csr_writeback_waddr_i(csr_writeback_waddr_w)
    ,.csr_writeback_wdata_i(csr_writeback_wdata_w)
    ,.csr_writeback_exception_i(csr_writeback_exception_w)
    ,.csr_writeback_exception_pc_i(csr_writeback_exception_pc_w)
    ,.csr_writeback_exception_addr_i(csr_writeback_exception_addr_w)
    ,.cpu_id_i(32'h00000000)
    ,.reset_vector_i(32'h00000000)
    ,.interrupt_inhibit_i(interrupt_inhibit_w)

    // Outputs
    ,.csr_result_e1_value_o(csr_result_e1_value_w)
    ,.csr_result_e1_write_o(csr_result_e1_write_w)
    ,.csr_result_e1_wdata_o(csr_result_e1_wdata_w)
    ,.csr_result_e1_exception_o(csr_result_e1_exception_w)
    ,.branch_csr_request_o(branch_csr_request_w)
    ,.branch_csr_pc_o(branch_csr_pc_w)
    ,.branch_csr_priv_o(branch_csr_priv_w)
    ,.take_interrupt_o(take_interrupt_w)
    ,.ifence_o(ifence_w)
    ,.mmu_priv_d_o(mmu_priv_d_w)
    ,.mmu_sum_o(mmu_sum_w)
    ,.mmu_mxr_o(mmu_mxr_w)
    ,.mmu_flush_o(mmu_flush_w)
    ,.mmu_satp_o(mmu_satp_w)
);


riscv_multiplier
u_mul
(
    // Inputs
     .clk_i(clk_i)
    ,.rst_i(rst_i)
    ,.opcode_valid_i(mul_opcode_valid_w)
    ,.opcode_opcode_i(mul_opcode_opcode_w)
    ,.opcode_pc_i(mul_opcode_pc_w)
    ,.opcode_invalid_i(mul_opcode_invalid_w)
    ,.opcode_rd_idx_i(mul_opcode_rd_idx_w)
    ,.opcode_ra_idx_i(mul_opcode_ra_idx_w)
    ,.opcode_rb_idx_i(mul_opcode_rb_idx_w)
    ,.opcode_ra_operand_i(mul_opcode_ra_operand_w)
    ,.opcode_rb_operand_i(mul_opcode_rb_operand_w)
    ,.hold_i(mul_hold_w)

    // Outputs
    ,.writeback_value_o(writeback_mul_value_w)
);


riscv_divider
u_div
(
    // Inputs
     .clk_i(clk_i)
    ,.rst_i(rst_i)
    ,.opcode_valid_i(div_opcode_valid_w)
    ,.opcode_opcode_i(opcode_opcode_w)
    ,.opcode_pc_i(opcode_pc_w)
    ,.opcode_invalid_i(opcode_invalid_w)
    ,.opcode_rd_idx_i(opcode_rd_idx_w)
    ,.opcode_ra_idx_i(opcode_ra_idx_w)
    ,.opcode_rb_idx_i(opcode_rb_idx_w)
    ,.opcode_ra_operand_i(opcode_ra_operand_w)
    ,.opcode_rb_operand_i(opcode_rb_operand_w)

    // Outputs
    ,.writeback_valid_o(writeback_div_valid_w)
    ,.writeback_value_o(writeback_div_value_w)
);


riscv_issue
#(
     .SUPPORT_REGFILE_XILINX(SUPPORT_REGFILE_XILINX)
    ,.SUPPORT_LOAD_BYPASS(SUPPORT_LOAD_BYPASS)
    ,.SUPPORT_MULDIV(SUPPORT_MULDIV)
    ,.SUPPORT_MUL_BYPASS(SUPPORT_MUL_BYPASS)
    ,.SUPPORT_DUAL_ISSUE(1)
)
u_issue
(
    // Inputs
     .clk_i(clk_i)
    ,.rst_i(rst_i)
    ,.fetch_valid_i(fetch_valid_w)
    ,.fetch_instr_i(fetch_instr_w)
    ,.fetch_pc_i(fetch_pc_w)
    ,.fetch_fault_fetch_i(fetch_fault_fetch_w)
    ,.fetch_fault_page_i(fetch_fault_page_w)
    ,.fetch_instr_exec_i(fetch_instr_exec_w)
    //matmul
    ,.fetch_instr_matmul_i(fetch_instr_matmul_w)
    ,.matmul_busy_i(matmul_busy_w)
    ,.fetch_instr_lsu_i(fetch_instr_lsu_w)
    ,.fetch_instr_branch_i(fetch_instr_branch_w)
    ,.fetch_instr_mul_i(fetch_instr_mul_w)
    ,.fetch_instr_div_i(fetch_instr_div_w)
    ,.fetch_instr_csr_i(fetch_instr_csr_w)
    ,.fetch_instr_rd_valid_i(fetch_instr_rd_valid_w)
    ,.fetch_instr_invalid_i(fetch_instr_invalid_w)
    ,.branch_exec_request_i(branch_exec_request_w)
    ,.branch_exec_is_taken_i(branch_exec_is_taken_w)
    ,.branch_exec_is_not_taken_i(branch_exec_is_not_taken_w)
    ,.branch_exec_source_i(branch_exec_source_w)
    ,.branch_exec_is_call_i(branch_exec_is_call_w)
    ,.branch_exec_is_ret_i(branch_exec_is_ret_w)
    ,.branch_exec_is_jmp_i(branch_exec_is_jmp_w)
    ,.branch_exec_pc_i(branch_exec_pc_w)
    ,.branch_d_exec_request_i(branch_d_exec_request_w)
    ,.branch_d_exec_pc_i(branch_d_exec_pc_w)
    ,.branch_d_exec_priv_i(branch_d_exec_priv_w)
    ,.branch_csr_request_i(branch_csr_request_w)
    ,.branch_csr_pc_i(branch_csr_pc_w)
    ,.branch_csr_priv_i(branch_csr_priv_w)
    ,.writeback_exec_value_i(writeback_exec_value_w)
    ,.writeback_mem_valid_i(writeback_mem_valid_w)
    ,.writeback_mem_value_i(writeback_mem_value_w)
    ,.writeback_mem_exception_i(writeback_mem_exception_w)
    ,.writeback_mul_value_i(writeback_mul_value_w)
    ,.writeback_div_valid_i(writeback_div_valid_w)
    ,.writeback_div_value_i(writeback_div_value_w)
    ,.csr_result_e1_value_i(csr_result_e1_value_w)
    ,.csr_result_e1_write_i(csr_result_e1_write_w)
    ,.csr_result_e1_wdata_i(csr_result_e1_wdata_w)
    ,.csr_result_e1_exception_i(csr_result_e1_exception_w)
    ,.lsu_stall_i(lsu_stall_w)
    ,.take_interrupt_i(take_interrupt_w)

    // Outputs    
    ,.fetch_accept_o(fetch_accept_w)
    ,.branch_request_o(branch_request_w)
    ,.branch_pc_o(branch_pc_w)
    ,.branch_priv_o(branch_priv_w)
    ,.exec_opcode_valid_o(exec_opcode_valid_w)
    ,.lsu_opcode_valid_o(lsu_opcode_valid_w)
    ,.csr_opcode_valid_o(csr_opcode_valid_w)
    ,.mul_opcode_valid_o(mul_opcode_valid_w)
    ,.div_opcode_valid_o(div_opcode_valid_w)
    ,.opcode_opcode_o(opcode_opcode_w)
    ,.opcode_pc_o(opcode_pc_w)
    ,.opcode_invalid_o(opcode_invalid_w)
    ,.opcode_rd_idx_o(opcode_rd_idx_w)
    ,.opcode_ra_idx_o(opcode_ra_idx_w)
    ,.opcode_rb_idx_o(opcode_rb_idx_w)
    ,.opcode_ra_operand_o(opcode_ra_operand_w)
    ,.opcode_rb_operand_o(opcode_rb_operand_w)
    ,.lsu_opcode_opcode_o(lsu_opcode_opcode_w)
    ,.lsu_opcode_pc_o(lsu_opcode_pc_w)
    ,.lsu_opcode_invalid_o(lsu_opcode_invalid_w)
    ,.lsu_opcode_rd_idx_o(lsu_opcode_rd_idx_w)
    ,.lsu_opcode_ra_idx_o(lsu_opcode_ra_idx_w)
    ,.lsu_opcode_rb_idx_o(lsu_opcode_rb_idx_w)
    ,.lsu_opcode_ra_operand_o(lsu_opcode_ra_operand_w)
    ,.lsu_opcode_rb_operand_o(lsu_opcode_rb_operand_w)
    ,.mul_opcode_opcode_o(mul_opcode_opcode_w)
    ,.mul_opcode_pc_o(mul_opcode_pc_w)
    ,.mul_opcode_invalid_o(mul_opcode_invalid_w)
    ,.mul_opcode_rd_idx_o(mul_opcode_rd_idx_w)
    ,.mul_opcode_ra_idx_o(mul_opcode_ra_idx_w)
    ,.mul_opcode_rb_idx_o(mul_opcode_rb_idx_w)
    ,.mul_opcode_ra_operand_o(mul_opcode_ra_operand_w)
    ,.mul_opcode_rb_operand_o(mul_opcode_rb_operand_w)
    ,.csr_opcode_opcode_o(csr_opcode_opcode_w)
    ,.csr_opcode_pc_o(csr_opcode_pc_w)
    ,.csr_opcode_invalid_o(csr_opcode_invalid_w)
    ,.csr_opcode_rd_idx_o(csr_opcode_rd_idx_w)
    ,.csr_opcode_ra_idx_o(csr_opcode_ra_idx_w)
    ,.csr_opcode_rb_idx_o(csr_opcode_rb_idx_w)
    ,.csr_opcode_ra_operand_o(csr_opcode_ra_operand_w)
    ,.csr_opcode_rb_operand_o(csr_opcode_rb_operand_w)
    ,.csr_writeback_write_o(csr_writeback_write_w)
    ,.csr_writeback_waddr_o(csr_writeback_waddr_w)
    ,.csr_writeback_wdata_o(csr_writeback_wdata_w)
    ,.csr_writeback_exception_o(csr_writeback_exception_w)
    ,.csr_writeback_exception_pc_o(csr_writeback_exception_pc_w)
    ,.csr_writeback_exception_addr_o(csr_writeback_exception_addr_w)
    ,.exec_hold_o(exec_hold_w)
    ,.mul_hold_o(mul_hold_w)
    ,.interrupt_inhibit_o(interrupt_inhibit_w),
    //matmul outputs 
    .matmul_start_o(matmul_start_w),                 
        .matmul_addr_a_o(matmul_addr_a_w),               
        .matmul_addr_b_o(matmul_addr_b_w),               
        .matmul_addr_c_o(matmul_addr_c_w)

);


riscv_fetch
#(
     .SUPPORT_MMU(SUPPORT_MMU)
)
u_fetch
(
    // Inputs
     .clk_i(clk_i)
    ,.rst_i(rst_i)
    ,.fetch_accept_i(fetch_dec_accept_w)
    ,.icache_accept_i(mmu_ifetch_accept_w)
    ,.icache_valid_i(mmu_ifetch_valid_w)
    ,.icache_error_i(mmu_ifetch_error_w)
    ,.icache_inst_i(mmu_ifetch_inst_w)
    ,.icache_page_fault_i(fetch_in_fault_w)
    ,.fetch_invalidate_i(ifence_w)
    ,.branch_request_i(branch_request_w)
    ,.branch_pc_i(branch_pc_w)
    ,.branch_priv_i(branch_priv_w)

    // Outputs
    ,.fetch_valid_o(fetch_dec_valid_w)
    ,.fetch_instr_o(fetch_dec_instr_w)
    ,.fetch_pc_o(fetch_dec_pc_w)
    ,.fetch_fault_fetch_o(fetch_dec_fault_fetch_w)
    ,.fetch_fault_page_o(fetch_dec_fault_page_w)
    ,.icache_rd_o(mmu_ifetch_rd_w)
    ,.icache_flush_o(mmu_ifetch_flush_w)
    ,.icache_invalidate_o(mmu_ifetch_invalidate_w)
    ,.icache_pc_o(mmu_ifetch_pc_w)
    ,.icache_priv_o(fetch_in_priv_w)
    ,.squash_decode_o(squash_decode_w)
);
//wrrapper and mmu logic

matmul_controller u_matmul_controller (
    .clk_i(clk_i),
    .rst_i(rst_i),
    .start_i(matmul_start_w),
    .addr_a_base_i(matmul_addr_a_w),
    .addr_b_base_i(matmul_addr_b_w),
    .addr_c_base_i(matmul_addr_c_w),
    .busy_o(matmul_busy_w),
    .mem_addr_o(matmul_mem_addr_w),
    .mem_rd_o(matmul_mem_rd_w),
    .mem_wr_o(matmul_mem_wr_w),
    .mem_data_wr_o(matmul_mem_data_wr_w),
    .mem_req_o(matmul_mem_req_w),
    .mem_data_rd_i(mem_d_data_rd_i),
    .mem_gnt_i(matmul_mem_gnt_w),
    .mem_ack_i(mem_d_ack_i)
);

// Memory arbitary logic
assign lsu_mem_req_w = lsu_mem_rd_w || (|lsu_mem_wr_w);

assign matmul_mem_gnt_w = matmul_mem_req_w;
assign lsu_mem_gnt_w    = lsu_mem_req_w && !matmul_mem_req_w;

assign arbitrated_mem_addr_w      = matmul_mem_gnt_w ? matmul_mem_addr_w    : lsu_mem_addr_w;
assign arbitrated_mem_data_wr_w   = matmul_mem_gnt_w ? matmul_mem_data_wr_w : lsu_mem_data_wr_w;
assign arbitrated_mem_rd_w        = matmul_mem_gnt_w ? matmul_mem_rd_w      : lsu_mem_rd_w;
assign arbitrated_mem_wr_w        = matmul_mem_gnt_w ? matmul_mem_wr_w      : lsu_mem_wr_w;
assign arbitrated_mem_cacheable_w = matmul_mem_gnt_w ? 1'b1                 : lsu_mem_cacheable_w;
assign arbitrated_mem_req_tag_w   = matmul_mem_gnt_w ? 11'd0                : lsu_mem_req_tag_w;
assign arbitrated_mem_invalidate_w= matmul_mem_gnt_w ? 1'b0                 : lsu_mem_invalidate_w;
assign arbitrated_mem_writeback_w = matmul_mem_gnt_w ? 1'b0                 : lsu_mem_writeback_w;
assign arbitrated_mem_flush_w     = matmul_mem_gnt_w ? 1'b0                 : lsu_mem_flush_w;

endmodule
