Anirudh-65/FPGA-Based_Hardware_Accelerated_Matrix-Multiplication_on_RISC-V_Using_Systolic-Array_Integration/riscv_matmul/design_modules/riscv_csr.v

//-----------------------------------------------------------------
//                         RISC-V Core
//                            V1.0.1
//                     Ultra-Embedded.com
//                     Copyright 2014-2019
//
//                   admin@ultra-embedded.com
//
//                       License: BSD
//-----------------------------------------------------------------
//
// Copyright (c) 2014-2019, Ultra-Embedded.com
// All rights reserved.
// 
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
`timescale 1ns / 1ps

module riscv_csr
//-----------------------------------------------------------------
// Params
//-----------------------------------------------------------------
#(
     parameter SUPPORT_MULDIV   = 1
    ,parameter SUPPORT_SUPER    = 1
)
//-----------------------------------------------------------------
// Ports
//-----------------------------------------------------------------
(
    // Inputs
     input           clk_i
    ,input           rst_i
    ,input           intr_i
    ,input           opcode_valid_i
    ,input  [ 31:0]  opcode_opcode_i
    ,input  [ 31:0]  opcode_pc_i
    ,input           opcode_invalid_i
    ,input  [  4:0]  opcode_rd_idx_i
    ,input  [  4:0]  opcode_ra_idx_i
    ,input  [  4:0]  opcode_rb_idx_i
    ,input  [ 31:0]  opcode_ra_operand_i
    ,input  [ 31:0]  opcode_rb_operand_i
    ,input           csr_writeback_write_i
    ,input  [ 11:0]  csr_writeback_waddr_i
    ,input  [ 31:0]  csr_writeback_wdata_i
    ,input  [  5:0]  csr_writeback_exception_i
    ,input  [ 31:0]  csr_writeback_exception_pc_i
    ,input  [ 31:0]  csr_writeback_exception_addr_i
    ,input  [ 31:0]  cpu_id_i
    ,input  [ 31:0]  reset_vector_i
    ,input           interrupt_inhibit_i

    // Outputs
    ,output [ 31:0]  csr_result_e1_value_o
    ,output          csr_result_e1_write_o
    ,output [ 31:0]  csr_result_e1_wdata_o
    ,output [  5:0]  csr_result_e1_exception_o
    ,output          branch_csr_request_o
    ,output [ 31:0]  branch_csr_pc_o
    ,output [  1:0]  branch_csr_priv_o
    ,output          take_interrupt_o
    ,output          ifence_o
    ,output [  1:0]  mmu_priv_d_o
    ,output          mmu_sum_o
    ,output          mmu_mxr_o
    ,output          mmu_flush_o
    ,output [ 31:0]  mmu_satp_o
);



//-----------------------------------------------------------------
// Includes
//-----------------------------------------------------------------
`include "riscv_defs.v"

//-----------------------------------------------------------------
// Registers / Wires
//-----------------------------------------------------------------
wire ecall_w             = opcode_valid_i && ((opcode_opcode_i & `INST_ECALL_MASK)      == `INST_ECALL);
wire ebreak_w            = opcode_valid_i && ((opcode_opcode_i & `INST_EBREAK_MASK)     == `INST_EBREAK);
wire eret_w              = opcode_valid_i && ((opcode_opcode_i & `INST_ERET_MASK)       == `INST_ERET);
wire [1:0] eret_priv_w   = opcode_opcode_i[29:28];
wire csrrw_w             = opcode_valid_i && ((opcode_opcode_i & `INST_CSRRW_MASK)      == `INST_CSRRW);
wire csrrs_w             = opcode_valid_i && ((opcode_opcode_i & `INST_CSRRS_MASK)      == `INST_CSRRS);
wire csrrc_w             = opcode_valid_i && ((opcode_opcode_i & `INST_CSRRC_MASK)      == `INST_CSRRC);
wire csrrwi_w            = opcode_valid_i && ((opcode_opcode_i & `INST_CSRRWI_MASK)     == `INST_CSRRWI);
wire csrrsi_w            = opcode_valid_i && ((opcode_opcode_i & `INST_CSRRSI_MASK)     == `INST_CSRRSI);
wire csrrci_w            = opcode_valid_i && ((opcode_opcode_i & `INST_CSRRCI_MASK)     == `INST_CSRRCI);
wire wfi_w               = opcode_valid_i && ((opcode_opcode_i & `INST_WFI_MASK)        == `INST_WFI);
wire fence_w             = opcode_valid_i && ((opcode_opcode_i & `INST_FENCE_MASK)      == `INST_FENCE);
wire sfence_w            = opcode_valid_i && ((opcode_opcode_i & `INST_SFENCE_MASK)     == `INST_SFENCE);
wire ifence_w            = opcode_valid_i && ((opcode_opcode_i & `INST_IFENCE_MASK)     == `INST_IFENCE);

//-----------------------------------------------------------------
// CSR handling
//-----------------------------------------------------------------
wire [1:0]  current_priv_w;
reg [1:0]   csr_priv_r;
reg         csr_readonly_r;
reg         csr_write_r;
reg         set_r;
reg         clr_r;
reg         csr_fault_r;

reg [31:0]  data_r;

always @ *
begin
    set_r           = csrrw_w | csrrs_w | csrrwi_w | csrrsi_w;
    clr_r           = csrrw_w | csrrc_w | csrrwi_w | csrrci_w;

    csr_priv_r      = opcode_opcode_i[29:28];
    csr_readonly_r  = (opcode_opcode_i[31:30] == 2'd3);
    csr_write_r     = (opcode_ra_idx_i != 5'b0) | csrrw_w | csrrwi_w;

    data_r          = (csrrwi_w | 
                       csrrsi_w | 
                       csrrci_w) ?
                            {27'b0, opcode_ra_idx_i} : opcode_ra_operand_i;

    // Detect access fault on CSR access
    csr_fault_r     = SUPPORT_SUPER ? (opcode_valid_i && (set_r | clr_r) && ((csr_write_r && csr_readonly_r) || (current_priv_w < csr_priv_r))) : 1'b0;
end

wire satp_update_w = (opcode_valid_i && (set_r || clr_r) && csr_write_r && (opcode_opcode_i[31:20] == `CSR_SATP));

//-----------------------------------------------------------------
// CSR register file
//-----------------------------------------------------------------
wire timer_irq_w = 1'b0;

wire [31:0] misa_w = SUPPORT_MULDIV ? (`MISA_RV32 | `MISA_RVI | `MISA_RVM): (`MISA_RV32 | `MISA_RVI);

wire [31:0] csr_rdata_w;

wire        csr_branch_w;
wire [31:0] csr_target_w;

wire [31:0] interrupt_w;
wire [31:0] status_reg_w;
wire [31:0] satp_reg_w;

riscv_csr_regfile
#( .SUPPORT_MTIMECMP(1)
  ,.SUPPORT_SUPER(SUPPORT_SUPER) )
u_csrfile
(
     .clk_i(clk_i)
    ,.rst_i(rst_i)

    ,.ext_intr_i(intr_i)
    ,.timer_intr_i(timer_irq_w)
    ,.cpu_id_i(cpu_id_i)
    ,.misa_i(misa_w)

    // Issue
    ,.csr_ren_i(opcode_valid_i)
    ,.csr_raddr_i(opcode_opcode_i[31:20])
    ,.csr_rdata_o(csr_rdata_w)

    // Exception (WB)
    ,.exception_i(csr_writeback_exception_i)
    ,.exception_pc_i(csr_writeback_exception_pc_i)
    ,.exception_addr_i(csr_writeback_exception_addr_i)

    // CSR register writes (WB)
    ,.csr_waddr_i(csr_writeback_write_i ? csr_writeback_waddr_i : 12'b0)
    ,.csr_wdata_i(csr_writeback_wdata_i)

    // CSR branches
    ,.csr_branch_o(csr_branch_w)
    ,.csr_target_o(csr_target_w)

    // Various CSR registers
    ,.priv_o(current_priv_w)
    ,.status_o(status_reg_w)
    ,.satp_o(satp_reg_w)

    // Masked interrupt output
    ,.interrupt_o(interrupt_w)
);

//-----------------------------------------------------------------
// CSR Read Result (E1) / Early exceptions
//-----------------------------------------------------------------
reg                     rd_valid_e1_q;
reg [ 31:0]             rd_result_e1_q;
reg [ 31:0]             csr_wdata_e1_q;
reg [`EXCEPTION_W-1:0]  exception_e1_q;

// Inappropriate xRET for the current exec priv level
wire                    eret_fault_w = eret_w && (current_priv_w < eret_priv_w);

always @ (posedge clk_i or posedge rst_i)
if (rst_i)
begin
    rd_valid_e1_q   <= 1'b0;
    rd_result_e1_q  <= 32'b0;
    csr_wdata_e1_q  <= 32'b0;
    exception_e1_q  <= `EXCEPTION_W'b0;
end
else if (opcode_valid_i)
begin
    rd_valid_e1_q   <= (set_r || clr_r) && ~csr_fault_r;

    // Invalid instruction / CSR access fault?
    // Record opcode for writing to csr_xtval later.
    if (opcode_invalid_i || csr_fault_r || eret_fault_w)
        rd_result_e1_q  <= opcode_opcode_i;
    else    
        rd_result_e1_q  <= csr_rdata_w;

    // E1 CSR exceptions
    if ((opcode_opcode_i & `INST_ECALL_MASK) == `INST_ECALL)
        exception_e1_q  <= `EXCEPTION_ECALL + {4'b0, current_priv_w};
    // xRET for priv level above this one - fault
    else if (eret_fault_w)
        exception_e1_q  <= `EXCEPTION_ILLEGAL_INSTRUCTION;
    else if ((opcode_opcode_i & `INST_ERET_MASK) == `INST_ERET)
        exception_e1_q  <= `EXCEPTION_ERET_U + {4'b0, eret_priv_w};
    else if ((opcode_opcode_i & `INST_EBREAK_MASK) == `INST_EBREAK)
        exception_e1_q  <= `EXCEPTION_BREAKPOINT;
    else if (opcode_invalid_i || csr_fault_r)
        exception_e1_q  <= `EXCEPTION_ILLEGAL_INSTRUCTION;
    // Fence / MMU settings cause a pipeline flush
    else if (satp_update_w || ifence_w || sfence_w)
        exception_e1_q  <= `EXCEPTION_FENCE;
    else
        exception_e1_q  <= `EXCEPTION_W'b0;

    // Value to be written to CSR registers
    if (set_r && clr_r)
        csr_wdata_e1_q <= data_r;
    else if (set_r)
        csr_wdata_e1_q <= csr_rdata_w | data_r;
    else if (clr_r)
        csr_wdata_e1_q <= csr_rdata_w & ~data_r;
end
else
begin
    rd_valid_e1_q   <= 1'b0;
    rd_result_e1_q  <= 32'b0;
    csr_wdata_e1_q  <= 32'b0;
    exception_e1_q  <= `EXCEPTION_W'b0;
end

assign csr_result_e1_value_o     = rd_result_e1_q;
assign csr_result_e1_write_o     = rd_valid_e1_q;
assign csr_result_e1_wdata_o     = csr_wdata_e1_q;
assign csr_result_e1_exception_o = exception_e1_q;

//-----------------------------------------------------------------
// Interrupt launch enable
//-----------------------------------------------------------------
reg take_interrupt_q;

always @ (posedge clk_i or posedge rst_i)
if (rst_i)
    take_interrupt_q    <= 1'b0;
else
    take_interrupt_q    <= (|interrupt_w) & ~interrupt_inhibit_i;

assign take_interrupt_o = take_interrupt_q;

//-----------------------------------------------------------------
// TLB flush
//-----------------------------------------------------------------
reg tlb_flush_q;

always @ (posedge clk_i or posedge rst_i)
if (rst_i)
    tlb_flush_q <= 1'b0;
else
    tlb_flush_q <= satp_update_w || sfence_w;

//-----------------------------------------------------------------
// ifence
//-----------------------------------------------------------------
reg ifence_q;

always @ (posedge clk_i or posedge rst_i)
if (rst_i)
    ifence_q    <= 1'b0;
else
    ifence_q    <= ifence_w;

assign ifence_o = ifence_q;

//-----------------------------------------------------------------
// Execute - Branch operations
//-----------------------------------------------------------------
reg        branch_q;
reg [31:0] branch_target_q;
reg        reset_q;

always @ (posedge clk_i or posedge rst_i)
if (rst_i)
begin
    branch_target_q <= 32'b0;
    branch_q        <= 1'b0;
    reset_q         <= 1'b1;
end
else if (reset_q)
begin
    branch_target_q <= reset_vector_i;
    branch_q        <= 1'b1;
    reset_q         <= 1'b0;
end
else
begin
    branch_q        <= csr_branch_w;
    branch_target_q <= csr_target_w;
end

assign branch_csr_request_o = branch_q;
assign branch_csr_pc_o      = branch_target_q;
assign branch_csr_priv_o    = satp_reg_w[`SATP_MODE_R] ? current_priv_w : `PRIV_MACHINE;

//-----------------------------------------------------------------
// MMU
//-----------------------------------------------------------------
assign mmu_priv_d_o     = status_reg_w[`SR_MPRV_R] ? status_reg_w[`SR_MPP_R] : current_priv_w;
assign mmu_satp_o       = satp_reg_w;
assign mmu_flush_o      = tlb_flush_q;
assign mmu_sum_o        = status_reg_w[`SR_SUM_R];
assign mmu_mxr_o        = status_reg_w[`SR_MXR_R];

endmodule
