Anirudh-65/FPGA-Based_Hardware_Accelerated_Matrix-Multiplication_on_RISC-V_Using_Systolic-Array_Integration/riscv_matmul/design_modules/riscv_regfile.v

//-----------------------------------------------------------------
//                         RISC-V Core
//                            V1.0.1
//                     Ultra-Embedded.com
//                     Copyright 2014-2019
//
//                   admin@ultra-embedded.com
//
//                       License: BSD
//-----------------------------------------------------------------
//
// Copyright (c) 2014-2019, Ultra-Embedded.com
// All rights reserved.
// 
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
// THIS SOFTWARE IS PROVIDED BY THE COPYRIGHT HOLDERS AND CONTRIBUTORS 
// "AS IS" AND ANY EXPRESS OR IMPLIED WARRANTIES, INCLUDING, BUT NOT 
// LIMITED TO, THE IMPLIED WARRANTIES OF MERCHANTABILITY AND FITNESS FOR 
// A PARTICULAR PURPOSE ARE DISCLAIMED. IN NO EVENT SHALL THE AUTHOR BE 
// LIABLE FOR ANY DIRECT, INDIRECT, INCIDENTAL, SPECIAL, EXEMPLARY, OR 
// CONSEQUENTIAL DAMAGES (INCLUDING, BUT NOT LIMITED TO, PROCUREMENT OF 
// SUBSTITUTE GOODS OR SERVICES; LOSS OF USE, DATA, OR PROFITS; OR 
// BUSINESS INTERRUPTION) HOWEVER CAUSED AND ON ANY THEORY OF 
// LIABILITY, WHETHER IN CONTRACT, STRICT LIABILITY, OR TORT
// (INCLUDING NEGLIGENCE OR OTHERWISE) ARISING IN ANY WAY OUT OF 
// THE USE OF THIS SOFTWARE, EVEN IF ADVISED OF THE POSSIBILITY OF 
// SUCH DAMAGE.
//-----------------------------------------------------------------
module riscv_regfile
//-----------------------------------------------------------------
// Params
//-----------------------------------------------------------------
#(
     parameter SUPPORT_REGFILE_XILINX = 0
)
//-----------------------------------------------------------------
// Ports
//-----------------------------------------------------------------
(
    // Inputs
     input           clk_i
    ,input           rst_i
    ,input  [  4:0]  rd0_i
    ,input  [ 31:0]  rd0_value_i
    ,input  [  4:0]  ra0_i
    ,input [4:0] rc0_i
    ,input  [  4:0]  rb0_i

    // Outputs
    ,output [ 31:0]  ra0_value_o
    ,output [ 31:0]  rb0_value_o
    ,output [31:0] rc0_value_o
);

//-----------------------------------------------------------------
// Xilinx specific register file (single issue)
//-----------------------------------------------------------------
generate
if (SUPPORT_REGFILE_XILINX)
begin: REGFILE_XILINX_SINGLE

    riscv_xilinx_2r1w
    u_reg
    (
        // Inputs
         .clk_i(clk_i)
        ,.rst_i(rst_i)
        ,.rd0_i(rd0_i)
        ,.rd0_value_i(rd0_value_i)
        ,.ra_i(ra0_i)
        ,.rb_i(rb0_i)

        // Outputs
        ,.ra_value_o(ra0_value_o)
        ,.rb_value_o(rb0_value_o)
    );
end
//-----------------------------------------------------------------
// Flop based register file
//-----------------------------------------------------------------
else
begin: REGFILE
    reg [31:0] reg_r1_q;
    reg [31:0] reg_r2_q;
    reg [31:0] reg_r3_q;
    reg [31:0] reg_r4_q;
    reg [31:0] reg_r5_q;
    reg [31:0] reg_r6_q;
    reg [31:0] reg_r7_q;
    reg [31:0] reg_r8_q;
    reg [31:0] reg_r9_q;
    reg [31:0] reg_r10_q;
    reg [31:0] reg_r11_q;
    reg [31:0] reg_r12_q;
    reg [31:0] reg_r13_q;
    reg [31:0] reg_r14_q;
    reg [31:0] reg_r15_q;
    reg [31:0] reg_r16_q;
    reg [31:0] reg_r17_q;
    reg [31:0] reg_r18_q;
    reg [31:0] reg_r19_q;
    reg [31:0] reg_r20_q;
    reg [31:0] reg_r21_q;
    reg [31:0] reg_r22_q;
    reg [31:0] reg_r23_q;
    reg [31:0] reg_r24_q;
    reg [31:0] reg_r25_q;
    reg [31:0] reg_r26_q;
    reg [31:0] reg_r27_q;
    reg [31:0] reg_r28_q;
    reg [31:0] reg_r29_q;
    reg [31:0] reg_r30_q;
    reg [31:0] reg_r31_q;

    // Simulation friendly names
    wire [31:0] x0_zero_w = 32'b0;
    wire [31:0] x1_ra_w   = reg_r1_q;
    wire [31:0] x2_sp_w   = reg_r2_q;
    wire [31:0] x3_gp_w   = reg_r3_q;
    wire [31:0] x4_tp_w   = reg_r4_q;
    wire [31:0] x5_t0_w   = reg_r5_q;
    wire [31:0] x6_t1_w   = reg_r6_q;
    wire [31:0] x7_t2_w   = reg_r7_q;
    wire [31:0] x8_s0_w   = reg_r8_q;
    wire [31:0] x9_s1_w   = reg_r9_q;
    wire [31:0] x10_a0_w  = reg_r10_q;
    wire [31:0] x11_a1_w  = reg_r11_q;
    wire [31:0] x12_a2_w  = reg_r12_q;
    wire [31:0] x13_a3_w  = reg_r13_q;
    wire [31:0] x14_a4_w  = reg_r14_q;
    wire [31:0] x15_a5_w  = reg_r15_q;
    wire [31:0] x16_a6_w  = reg_r16_q;
    wire [31:0] x17_a7_w  = reg_r17_q;
    wire [31:0] x18_s2_w  = reg_r18_q;
    wire [31:0] x19_s3_w  = reg_r19_q;
    wire [31:0] x20_s4_w  = reg_r20_q;
    wire [31:0] x21_s5_w  = reg_r21_q;
    wire [31:0] x22_s6_w  = reg_r22_q;
    wire [31:0] x23_s7_w  = reg_r23_q;
    wire [31:0] x24_s8_w  = reg_r24_q;
    wire [31:0] x25_s9_w  = reg_r25_q;
    wire [31:0] x26_s10_w = reg_r26_q;
    wire [31:0] x27_s11_w = reg_r27_q;
    wire [31:0] x28_t3_w  = reg_r28_q;
    wire [31:0] x29_t4_w  = reg_r29_q;
    wire [31:0] x30_t5_w  = reg_r30_q;
    wire [31:0] x31_t6_w  = reg_r31_q;

    //-----------------------------------------------------------------
    // Flop based register File (for simulation)
    //-----------------------------------------------------------------

    // Synchronous register write back
    always @ (posedge clk_i )
    if (rst_i)
    begin
        reg_r1_q       <= 32'h00000000;
        reg_r2_q       <= 32'h00000000;
        reg_r3_q       <= 32'h00000000;
        reg_r4_q       <= 32'h00000000;
        reg_r5_q       <= 32'h00000000;
        reg_r6_q       <= 32'h00000000;
        reg_r7_q       <= 32'h00000000;
        reg_r8_q       <= 32'h00000000;
        reg_r9_q       <= 32'h00000000;
        reg_r10_q      <= 32'h00000000;
        reg_r11_q      <= 32'h00000000;
        reg_r12_q      <= 32'h00000000;
        reg_r13_q      <= 32'h00000000;
        reg_r14_q      <= 32'h00000000;
        reg_r15_q      <= 32'h00000000;
        reg_r16_q      <= 32'h00000000;
        reg_r17_q      <= 32'h00000000;
        reg_r18_q      <= 32'h00000000;
        reg_r19_q      <= 32'h00000000;
        reg_r20_q      <= 32'h00000000;
        reg_r21_q      <= 32'h00000000;
        reg_r22_q      <= 32'h00000000;
        reg_r23_q      <= 32'h00000000;
        reg_r24_q      <= 32'h00000000;
        reg_r25_q      <= 32'h00000000;
        reg_r26_q      <= 32'h00000000;
        reg_r27_q      <= 32'h00000000;
        reg_r28_q      <= 32'h00000000;
        reg_r29_q      <= 32'h00000000;
        reg_r30_q      <= 32'h00000000;
        reg_r31_q      <= 32'h00000000;
    end
    else
    begin
        if      (rd0_i == 5'd1) reg_r1_q <= rd0_value_i;
        if      (rd0_i == 5'd2) reg_r2_q <= rd0_value_i;
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
        //5'd21: reg_r21_q <= value;
        //5'd22: reg_r22_q <= value;
        //5'd23: reg_r23_q <= value;
        //5'd24: reg_r24_q <= value;
        //5'd25: reg_r25_q <= value;
        //5'd26: reg_r26_q <= value;
        //5'd27: reg_r27_q <= value;
        //5'd28: reg_r28_q <= value;
        //5'd29: reg_r29_q <= value;
        //5'd30: reg_r30_q <= value;
        //5'd31: reg_r31_q <= value;
        //default :
        //    ;
        //endcase
    end
    endfunction
    `endif

end
endgenerate

endmodule
