Anirudh-65/FPGA-Based_Hardware_Accelerated_Matrix-Multiplication_on_RISC-V_Using_Systolic-Array_Integration/riscv_matmul/design_modules/riscv_alu.v

//-----------------------------------------------------------------
//                         RISC-V Core
//                            V1.0.1
//                     Ultra-Embedded.com
//                     Copyright 2014-2019
//
//                   admin@ultra-embedded.com
//
//                       License: BSD
//-----------------------------------------------------------------
//
// Copyright (c) 2014-2019, Ultra-Embedded.com
// All rights reserved.
// 
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
// THIS SOFTWARE IS PROVIDED BY THE COPYRIGHT HOLDERS AND CONTRIBUTORS 
// "AS IS" AND ANY EXPRESS OR IMPLIED WARRANTIES, INCLUDING, BUT NOT 
// LIMITED TO, THE IMPLIED WARRANTIES OF MERCHANTABILITY AND FITNESS FOR 
// A PARTICULAR PURPOSE ARE DISCLAIMED. IN NO EVENT SHALL THE AUTHOR BE 
// LIABLE FOR ANY DIRECT, INDIRECT, INCIDENTAL, SPECIAL, EXEMPLARY, OR 
// CONSEQUENTIAL DAMAGES (INCLUDING, BUT NOT LIMITED TO, PROCUREMENT OF 
// SUBSTITUTE GOODS OR SERVICES; LOSS OF USE, DATA, OR PROFITS; OR 
// BUSINESS INTERRUPTION) HOWEVER CAUSED AND ON ANY THEORY OF 
// LIABILITY, WHETHER IN CONTRACT, STRICT LIABILITY, OR TORT
// (INCLUDING NEGLIGENCE OR OTHERWISE) ARISING IN ANY WAY OUT OF 
// THE USE OF THIS SOFTWARE, EVEN IF ADVISED OF THE POSSIBILITY OF 
// SUCH DAMAGE.
//-----------------------------------------------------------------
`timescale 1ns / 1ps
module riscv_alu
(
    // Inputs
     input  [  3:0]  alu_op_i
    ,input  [ 31:0]  alu_a_i
    ,input  [ 31:0]  alu_b_i

    // Outputs
    ,output [ 31:0]  alu_p_o
);

//-----------------------------------------------------------------
// Includes
//-----------------------------------------------------------------
`include "riscv_defs.v"

//-----------------------------------------------------------------
// Registers
//-----------------------------------------------------------------
reg [31:0]      result_r;

reg [31:16]     shift_right_fill_r;
reg [31:0]      shift_right_1_r;
reg [31:0]      shift_right_2_r;
reg [31:0]      shift_right_4_r;
reg [31:0]      shift_right_8_r;

reg [31:0]      shift_left_1_r;
reg [31:0]      shift_left_2_r;
reg [31:0]      shift_left_4_r;
reg [31:0]      shift_left_8_r;

wire [31:0]     sub_res_w = alu_a_i - alu_b_i;

//-----------------------------------------------------------------
// ALU
//-----------------------------------------------------------------
always @ (alu_op_i or alu_a_i or alu_b_i or sub_res_w)
begin
    shift_right_fill_r = 16'b0;
    shift_right_1_r = 32'b0;
    shift_right_2_r = 32'b0;
    shift_right_4_r = 32'b0;
    shift_right_8_r = 32'b0;

    shift_left_1_r = 32'b0;
    shift_left_2_r = 32'b0;
    shift_left_4_r = 32'b0;
    shift_left_8_r = 32'b0;

    case (alu_op_i)
       //----------------------------------------------
       // Shift Left
       //----------------------------------------------   
       `ALU_SHIFTL :
       begin
            if (alu_b_i[0] == 1'b1)
                shift_left_1_r = {alu_a_i[30:0],1'b0};
            else
                shift_left_1_r = alu_a_i;

            if (alu_b_i[1] == 1'b1)
                shift_left_2_r = {shift_left_1_r[29:0],2'b00};
            else
                shift_left_2_r = shift_left_1_r;

            if (alu_b_i[2] == 1'b1)
                shift_left_4_r = {shift_left_2_r[27:0],4'b0000};
            else
                shift_left_4_r = shift_left_2_r;

            if (alu_b_i[3] == 1'b1)
                shift_left_8_r = {shift_left_4_r[23:0],8'b00000000};
            else
                shift_left_8_r = shift_left_4_r;

            if (alu_b_i[4] == 1'b1)
                result_r = {shift_left_8_r[15:0],16'b0000000000000000};
            else
                result_r = shift_left_8_r;
       end
       //----------------------------------------------
       // Shift Right
       //----------------------------------------------
       `ALU_SHIFTR, `ALU_SHIFTR_ARITH:
       begin
            // Arithmetic shift? Fill with 1's if MSB set
            if (alu_a_i[31] == 1'b1 && alu_op_i == `ALU_SHIFTR_ARITH)
                shift_right_fill_r = 16'b1111111111111111;
            else
                shift_right_fill_r = 16'b0000000000000000;

            if (alu_b_i[0] == 1'b1)
                shift_right_1_r = {shift_right_fill_r[31], alu_a_i[31:1]};
            else
                shift_right_1_r = alu_a_i;

            if (alu_b_i[1] == 1'b1)
                shift_right_2_r = {shift_right_fill_r[31:30], shift_right_1_r[31:2]};
            else
                shift_right_2_r = shift_right_1_r;

            if (alu_b_i[2] == 1'b1)
                shift_right_4_r = {shift_right_fill_r[31:28], shift_right_2_r[31:4]};
            else
                shift_right_4_r = shift_right_2_r;

            if (alu_b_i[3] == 1'b1)
                shift_right_8_r = {shift_right_fill_r[31:24], shift_right_4_r[31:8]};
            else
                shift_right_8_r = shift_right_4_r;

            if (alu_b_i[4] == 1'b1)
                result_r = {shift_right_fill_r[31:16], shift_right_8_r[31:16]};
            else
                result_r = shift_right_8_r;
       end       
       //----------------------------------------------
       // Arithmetic
       //----------------------------------------------
       `ALU_ADD : 
       begin
            result_r      = (alu_a_i + alu_b_i);
       end
       `ALU_SUB : 
       begin
            result_r      = sub_res_w;
       end
       //----------------------------------------------
       // Logical
       //----------------------------------------------       
       `ALU_AND : 
       begin
            result_r      = (alu_a_i & alu_b_i);
       end
       `ALU_OR  : 
       begin
            result_r      = (alu_a_i | alu_b_i);
       end
       `ALU_XOR : 
       begin
            result_r      = (alu_a_i ^ alu_b_i);
       end
       //----------------------------------------------
       // Comparision
       //----------------------------------------------
       `ALU_LESS_THAN : 
       begin
            result_r      = (alu_a_i < alu_b_i) ? 32'h1 : 32'h0;
       end
       `ALU_LESS_THAN_SIGNED : 
       begin
            if (alu_a_i[31] != alu_b_i[31])
                result_r  = alu_a_i[31] ? 32'h1 : 32'h0;
            else
                result_r  = sub_res_w[31] ? 32'h1 : 32'h0;            
       end       
       default  : 
       begin
            result_r      = alu_a_i;
       end
    endcase
end

assign alu_p_o    = result_r;

endmodule
