Anirudh-65/FPGA-Based_Hardware_Accelerated_Matrix-Multiplication_on_RISC-V_Using_Systolic-Array_Integration/riscv_matmul/New_designs/riscv_performance_counter.v

`timescale 1ns / 1ps
//////////////////////////////////////////////////////////////////////////////////
// Company: 
// Engineer: 
// 
// Create Date: 27.06.2025 16:18:26
// Design Name: 
// Module Name: riscv_performance_counter
// Project Name: 
// Target Devices: 
// Tool Versions: 
// Description: 
// 
// Dependencies: 
// 
// Revision:
// Revision 0.01 - File Created
// Additional Comments:
// 
//////////////////////////////////////////////////////////////////////////////////


`timescale 1ns / 1ps
module riscv_performance_counter (
    input wire clk_i,
    input wire reset_i,
    input wire [31:0] pc_i,              
    input wire [31:0] instruction_i,     
    input wire instruction_valid_i,      
    output reg [31:0] cycle_count_o,     
    output reg counting_active_o,        
    output reg measurement_done_o,       
    output wire halt_detected_o          
);
    
    localparam IDLE = 2'b00;
    localparam COUNTING = 2'b01;
    localparam DONE = 2'b10;

    localparam HALT_INSTRUCTION = 32'hFFFFFFFF;

    reg [1:0] state, next_state;
    reg [31:0] counter;
    reg first_instruction_detected;
    reg halt_flag;

    wire halt_instruction;
    assign halt_instruction = (pc_i == 32'd88) && instruction_valid_i;
    assign halt_detected_o = halt_flag;

 wire start_condition;
    assign start_condition = (pc_i == 32'h00000000) && instruction_valid_i;
    always @(posedge clk_i or posedge reset_i) begin
        if (reset_i) begin
            state <= IDLE;
            counter <= 32'b0;
            first_instruction_detected <= 1'b0;
            halt_flag <= 1'b0;
        end else begin
            state <= next_state;

            if (state == COUNTING && instruction_valid_i) begin
                counter <= counter + 1;
            end

            if (halt_instruction) begin
                halt_flag <= 1'b1;
            end

            if (start_condition && !first_instruction_detected) begin
                first_instruction_detected <= 1'b1;
            end
        end
    end

    always @(*) begin
        next_state = state;
        case (state)
            IDLE: begin
                if (start_condition && !first_instruction_detected) begin
                    next_state = COUNTING;
                end
            end
            COUNTING: begin
                if (halt_instruction) begin
                    next_state = DONE;
                end
            end
            DONE: begin
      
                next_state = DONE;
            end
            default: next_state = IDLE;
        endcase
    end

    always @(posedge clk_i or posedge reset_i) begin
        if (reset_i) begin
            cycle_count_o <= 32'b0;
            counting_active_o <= 1'b0;
            measurement_done_o <= 1'b0;
        end else begin
            case (state)
                IDLE: begin
                    counting_active_o <= 1'b0;
                    measurement_done_o <= 1'b0;
                end
                COUNTING: begin
                    counting_active_o <= 1'b1;
                    measurement_done_o <= 1'b0;
                end
                DONE: begin
                    counting_active_o <= 1'b0;
                    measurement_done_o <= 1'b1;
                    cycle_count_o <= counter;
                end
                default: begin
                    counting_active_o <= 1'b0;
                    measurement_done_o <= 1'b0;
                end
            endcase
        end
    end

endmodule
